tandav/ultrasonic-stethoscope/docs/tech/due.md

# some links for arduino due

If cannnot upload, arduino ide dont see port / try to change usb port / programming -> native and vice versa
- also try to upload via programming port / not native. Native sometimes stucks

---
- [DueTimer: ⏳ Timer Library fully implemented for Arduino DUE](https://github.com/ivanseidel/DueTimer)
- [SineWaveDue: Sinewave library for the Arduino Due](https://github.com/cmasenas/SineWaveDue)
- [Arduino Due: ADC → DMA → USB @ 1MSPS](https://gist.github.com/pklaus/5921022)
- [snowWhiteNoise: Spectrum Analyzer with Arduino: An Arduino Due and a PC give ...](https://github.com/hamed/snowWhiteNoise)
- [arduino-libraries/Scheduler: Scheduler Library for Arduino](https://github.com/arduino-libraries/Scheduler)
    - [Arduino - Scheduler](https://www.arduino.cc/en/Reference/Scheduler)
    - [Tasks: A Time-Triggered Scheduler for Arduino | chris barlow](https://chrisbarlow.wordpress.com/2016/04/27/tasks-a-time-triggered-scheduler-for-arduino/)
    - [Arduino Due Task Scheduler](https://forum.arduino.cc/index.php?topic=130917.0)
    - [Simple Arduino Scheduler](https://forum.arduino.cc/index.php?topic=372119.0)
    - [arduino scheduler what is yield - Google Search](https://www.google.com/search?q=arduino+scheduler+what+is+yield)
    - [Using yield () within scheduled loops](https://forum.arduino.cc/index.php?topic=450589.0)
    - [esp8266 - What is the secret of the arduino `yield()`function? - Stack Overflow](https://stackoverflow.com/questions/34497758/what-is-the-secret-of-the-arduino-yieldfunction#)
    - [Yield Function, Printable Class and Mapping Arrays : Useful But Unknown Features from Arduino Core - Atadiat](https://atadiat.com/en/e-yield-function-printable-class-mapping-arrays-useful-arduino-core/)
    - [Arduinoesp8266 Multipletasks | euphi.github.io](https://euphi.github.io/2018/03/31/ArduinoESP8266-multipleTasks.html)
    - [ESP8266 Thing Hookup Guide - learn.sparkfun.com](https://learn.sparkfun.com/tutorials/esp8266-thing-hookup-guide/using-the-arduino-addon)
