tandav/ultrasonic-stethoscope/docs/tech/bad-mic-glue.md

# Bad Mic Glue
-Новый  mic - стремно приклеен - переделать мб. Там амплитуда меньше чем у старого.
- если самому не получится то в ЧТ и пятницу (16, 17 ноября) можно с ним
- а так - разматываешь, вокруг мика клеем мажешь (либо старый плавишь) + феном прикладываешь (держишь пинцетами)
- потом усадку сверху. Она по идее стремно должна но как то
