tandav/ultrasonic-stethoscope/docs/tech/Arduino.md

Короче 2 функции `setup()` и `loop()`

В пин А(любой) вставляешь `mic`, нужно перепаять `op-amp` под `0-3.3V`

Можно протестить - подать сигнал с DAC на ADC (ну провод-перемычку наверное, хз)

В инициализации выбирать скорость com-порта. Ну там максималку поставить (250000?), по дефолту в районе 115000

И с ком порта в каком-нибудь питоне / visual студии считывать данные с ком порта, они там будут. Типа рисовать на график.

Потом короче можно изучать как не через COM, а через native-USB.
 через python / visual studio plot chart from COM-port
	- Ну и потом from native-usb

---

My app based on https://gist.github.com/pklaus/5921022

---
