tandav/ultrasonic-stethoscope/docs/master-thesis/paper/sections/0-titlepage.tex

% !TEX root = ../main.tex
\documentclass[../main.tex]{subfiles}
\begin{titlepage}

\begin{document}
\begin{spacing}{1.2}
{
\sffamily 
\begin{small}
\thispagestyle{empty}
\newgeometry{margin=2cm}
\center
\begin{singlespace}
МИНОБРНАУКИ РОССИИ\\
\begin{bfseries}
ФЕДЕРАЛЬНОЕ ГОСУДАРСТВЕННОЕ БЮДЖЕТНОЕ ОБРАЗОВАТЕЛЬНОЕ УЧРЕЖДЕНИЕ

ВЫСШЕГО ОБРАЗОВАНИЯ

``ВОРОНЕЖСКИЙ ГОСУДАРСТВЕННЫЙ УНИВЕРСИТЕТ''
\end{bfseries}
\end{singlespace}

\vspace{0.5cm}
{Факультет \textit{компьютерных наук}}\\
{Кафедра \textit{цифровых технологий}}\\

\vspace{1.5cm}

\textit{Цифровая акустическая система оценки состояния лёгких}\\

\vspace{1.5cm}

{ВКР} \textit{Магистерская диссертация}\\
\textit{02.04.01 Математика и компьютерные науки}\\
\textit{Компьютерное моделирование и искусственный интеллект}\\

\vspace{3cm}
\begin{flushleft}
{Допущено к защите в ГЭК}
\end{flushleft}
\begin{tabbing}
ооооооооооооооо	\=	----------------------	\kill
Зав. кафедрой\> 	\rule[0mm]{3cm}{0,3mm}	\textit{С.Д. Кургалин, д. ф.-м. н., профессор}{ \rule[0mm]{5mm}{0,3mm}.\rule[0mm]{5mm}{0,3mm}.2019}  \\
Обучающийся \> 	\rule[0mm]{3cm}{0,3mm}	\textit{А.А. Родионов, 2 курс, д/о} \\ 
ооооооооооооооо	\=	----------------------	\kill
Руководитель\> 	\rule[0mm]{3cm}{0,3mm}  \textit{Я.А. Туровский, к. мед. н., доцент }
\end{tabbing}

\vspace{4cm}

\centerline{Воронеж 2019}
\end{small}
}
\end{spacing}
\newpage

\end{document}
\end{titlepage}
