tandav/ultrasonic-stethoscope/docs/master-thesis/paper/sections/zadanie.tex

% !TEX root = ../main.tex
\documentclass[../main.tex]{subfiles}

\begin{document}
% \thispagestyle{empty}

{
\sffamily
\begin{small}
\begin{spacing}{1.2}
{
\begin{center}
{МИНОБРНАУКИ РОССИИ}\\ \!
{\footnotesize\textbf{ФЕДЕРАЛЬНОЕ ГОСУДАРСТВЕННОЕ БЮДЖЕТНОЕ ОБРАЗОВАТЕЛЬНОЕ УЧРЕЖДЕНИЕ}\\ \!\!\textbf{ВЫСШЕГО ОБРАЗОВАНИЯ}}\\
\textbf{<<ВОРОНЕЖСКИЙ ГОСУДАРСТВЕННЫЙ УНИВЕРСИТЕТ>>}\\
{Факультет компьютерных наук}\\
{Кафедра цифровых технологий}\\
\vspace{0.1cm}
\end{center}
\begin{flushright} \!  \!  \! \!
\textbf{УТВЕРЖДАЮ}\\
заведующий кафедрой\\
$\underset{\text{\emph{подпись}}}{\underline{\hspace{0.15\textwidth}}}$ $\underset{\text{\emph{расшифровка подписи}}}{\text{Кургалин С.Д.},}$
\end{flushright}
\begin{center}
{\small \textbf{ЗАДАНИЕ \\
НА ВЫПОЛНЕНИЕ ВЫПУСКНОЙ КВАЛИФИКАЦИОННОЙ РАБОТЫ\\
ОБУЧАЮЩЕГОСЯ} $\underset{\text{\emph{фамилия, имя, отчество}}}{\underline{\textbf{РОДИОНОВА АЛЕКСАНДРА АЛЕКСАНДРОВИЧА}}}$}
\end{center}\! \! \!
\vspace{0.1cm}
{
\footnotesize 1. Тема работы \underline{\phantom{aaa}<<Цифровая акустическая система оценки состояния лёгких>> \phantom{a}}, утверждена решением ученого совета факультета компьютерных наук от \underline{\phantom{aaa}}.\underline{\phantom{aaa}}.20\underline{\phantom{aaa}}\\
2. { Направление подготовки $\underset{\text{\emph{шифр, наименование}}}{\underline{\phantom{aaaaa}\text{02.04.01 Математика и компьютерные науки.}\phantom{aaaaa}}}$\\
3. Срок сдачи студентом законченной работы \underline{\phantom{aaa}}.\underline{\phantom{aaa}}.20\underline{\phantom{aaa}}\\
4. Календарный план:}\\
\begin{table}[h]
\centering
% \begin{tabular}{|P{3em}|p{25em}|P{12em}|P{7em}|}
\begin{tabular}{|l|l|l|l|}
\hline
{\footnotesize  №} & {\hspace{0.18\textwidth}{\footnotesize Структура ВКР}} & {\footnotesize Сроки выполнения } & {\footnotesize Примечание}\\\hline
{1} & {Введение}                                        & {03.09.2017} & {}\\\hline
{2} & {Глава 1. Цель и задачи }                         & {10.11.2017} & {}\\\hline
{3} & {Глава 2. Анализ предметной области}              & {15.02.2018} & {}\\\hline
{4} & {Глава 3. Модель распространения звука в легких}  & {06.04.2018} & {}\\\hline
{5} & {Глава 4. Аппаратная часть разработанной системы} & {20.11.2018} & {}\\\hline
{6} & {Глава 5. Програмная часть разработанной системы} & {13.02.2019} & {}\\\hline
{7} & {Заключение}                                      & {11.05.2019} & {}\\\hline
{8} & {Список использованных источников}                & {03.06.2019} & {}\\\hline
\end{tabular}
% \! \! \! \!
\end{table}

\begin{flushleft}
\vspace{0.4cm}
{\small
Обучающийся $~~~~~~~~\underset{\textit{подпись}}{\rule[-1.8mm]{3cm}{0,25mm}}$ $\underset{\textit{расшифровка подписи}}{\underline{\phantom{aaaaaaa}\text{Родионов А.А.}\phantom{aaaaaaa}}}$\\
\vspace{0.4cm}
Руководитель $~~~~~~~~~\underset{\text{\emph{подпись}}}{\rule[-1.6mm]{3cm}{0,25mm}}$ $\underset{\text{\emph{расшифровка подписи}}}{\underline{\phantom{aaaaaaaa}\text{Туровский Я.А.}\phantom{aaaaaaa.}}}$}
\end{flushleft}\! \! \! \! \! \! \! \!
}
}
\end{spacing}
\end{small}
}
\newpage

\end{document}
