tandav/ultrasonic-stethoscope/docs/bachelor-thesis/presentation.pdf

# Цифровой úирокополоснýй стетоскоп

## Вýполнил: Александр Родионов 4к 6гр

## Руководителþ: Я.А. Туровский

# Проблема

# Проблема

## - 5/10 приùин смерти в мире свзанý с заболеваними сердøа или легких (ВОЗ, 2015)

# Проблема

## - 5/10 приùин смерти в мире свзанý с заболеваними сердøа или легких (ВОЗ, 2015) - Основной инструмент медиøинской диагностики враùей первиùного звена - стетоскоп

# Проблема

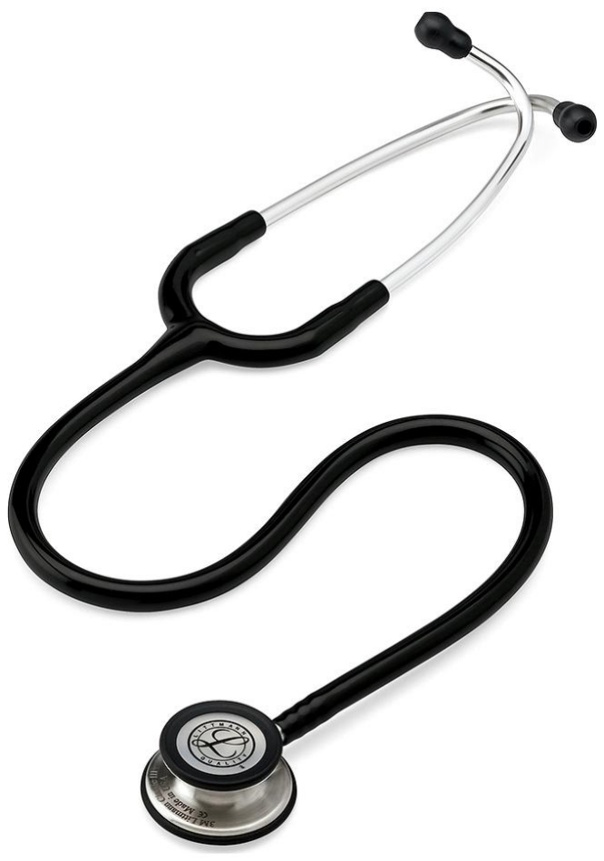
[picture p5: figure]

## - 5/10 приùин смерти в мире свзанý с заболеваними сердøа или легких (ВОЗ, 2015) - Основной инструмент медиøинской диагностики враùей первиùного звена - стетоскоп

# Проблема

## - 5/10 приùин смерти в мире свзанý с заболеваними сердøа или легких (ВОЗ, 2015) - Основной инструмент медиøинской диагностики враùей первиùного звена - стетоскоп - Информаøи, на основе которой враù назнаùает далþнейúее леùение субüективна

# Проблема

- 5/10 приùин смерти в мире свзанý с заболеваними сердøа или легких (ВОЗ, 2015) - Основной инструмент медиøинской диагностики враùей первиùного звена - стетоскоп - Информаøи, на основе которой враù назнаùает далþнейúее леùение субüективна - Естþ потребностþ в стетоскопах, которýе дат возможностþ работатþ с более обüективной информаøией

# Целþ работý

## Разработка øифрового úирокополосного стетоскопа, работаûего в

слýúимом и нижнем улþтразвуковом диапазоне (до 40кГø) и ПО к нему.

# Аналоги на рýнке

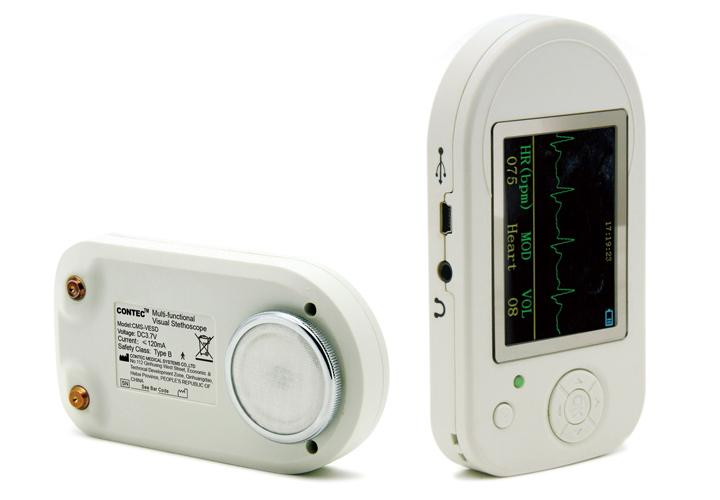
[picture p6: figure]

CMS-VESD
5800 руб

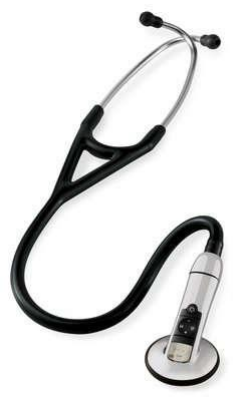
[picture p7: figure]

Littmann 3200
22000 руб

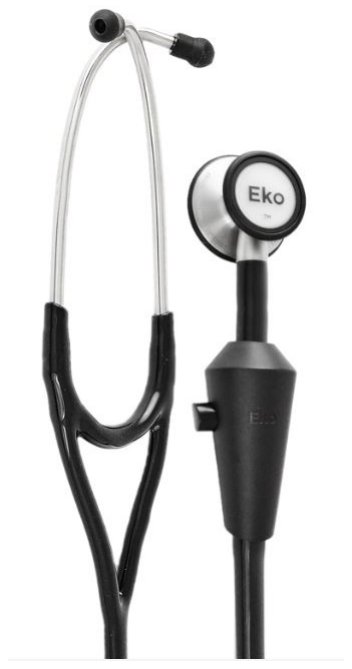
[picture p8: figure]

Eko Core
16900 руб

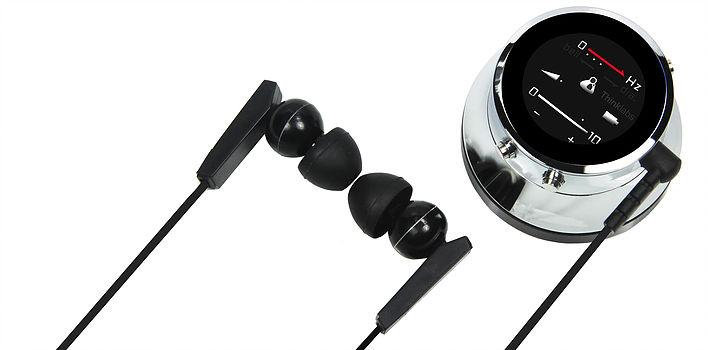
[picture p9: figure]

Thinklabs One
26800 руб

# Задаùи

# Задаùи

## 1. Вýбор микрофона

# Задаùи

## 1. Вýбор микрофона 2. Разработка усилител дл микрофона

# Задаùи

## 1. Вýбор микрофона 2. Разработка усилител дл микрофона 3. Вýбор АЦП

# Задаùи

## 1. Вýбор микрофона 2. Разработка усилител дл микрофона 3. Вýбор АЦП 4. Разработка ПО дл обработки и визуализаøии даннýх

# Задаùи

## 1. Вýбор микрофона 2. Разработка усилител дл микрофона 3. Вýбор АЦП 4. Разработка ПО дл обработки и визуализаøии даннýх 5. Разработка ПО дл вýсокопроизводителþной обработки сигнала на удаленном сервере

# Микрофон: Sven MK-200

# Микрофон: Sven MK-200

50Hz | 16kHz

Наилучшая чувствительность

# Микрофон: Sven MK-200

50Hz | 16kHz | 40kHz
Наилучшая чувствительность | С ослаблением

# Усилителþ

# Усилителþ

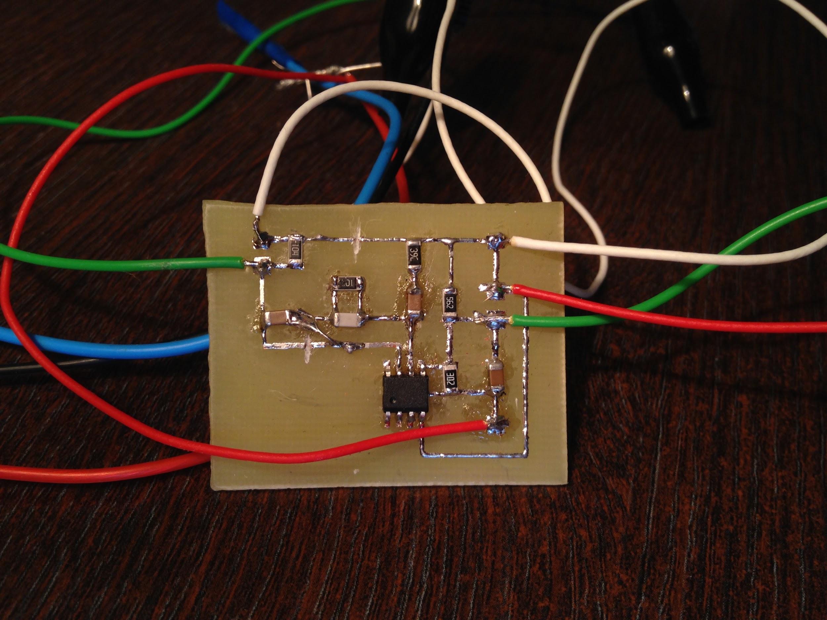
[picture p10: figure]
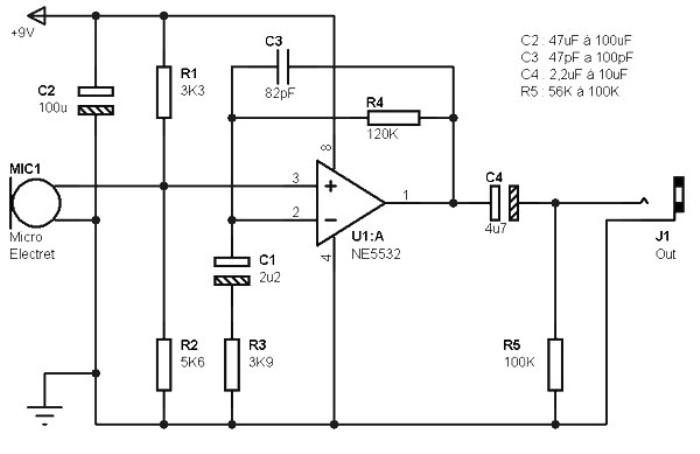
[picture p11: figure]

# Усилителþ

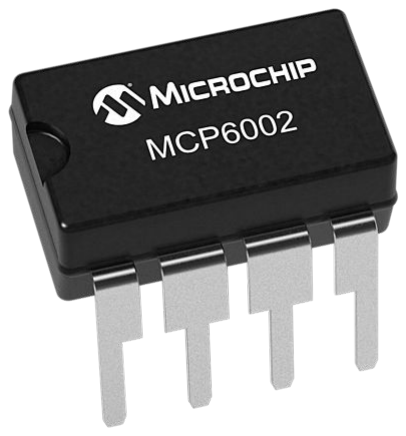
[picture p12: figure]

MSP 6022:

# Усилителþ

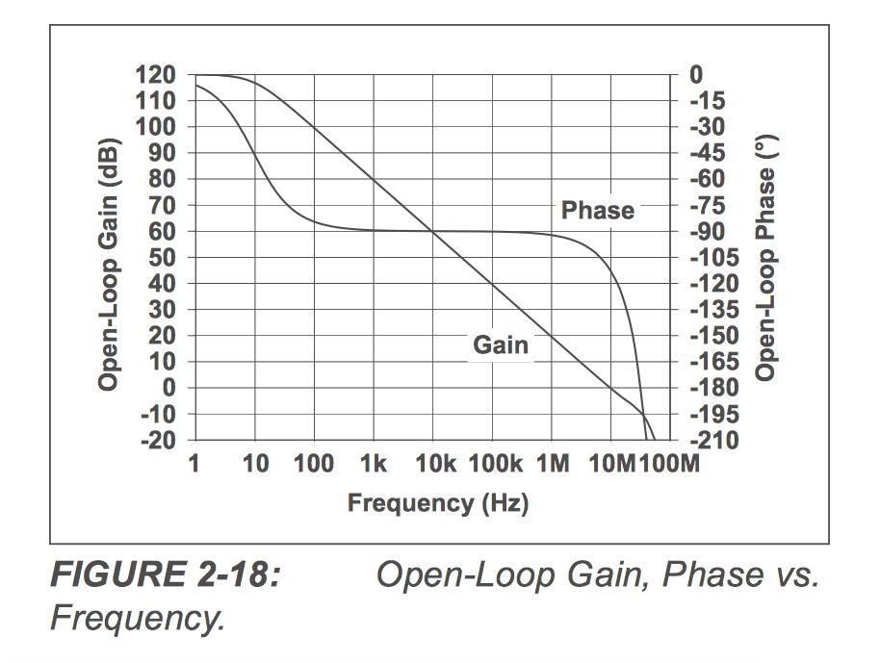
[picture p13: figure]

# Усилителþ

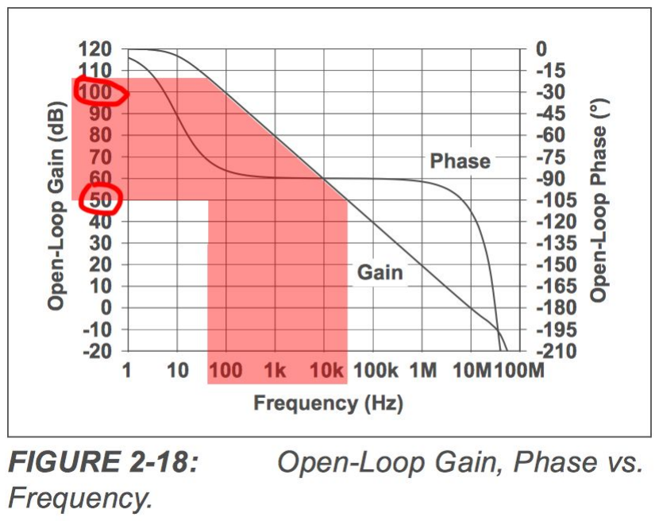
[picture p14: figure]

# АЦП

# АЦП

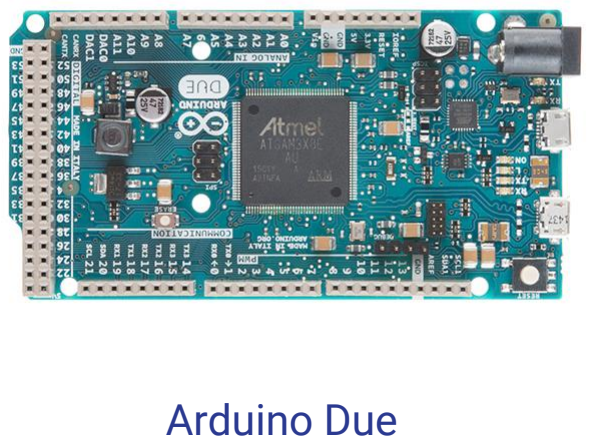
[picture p15: figure]
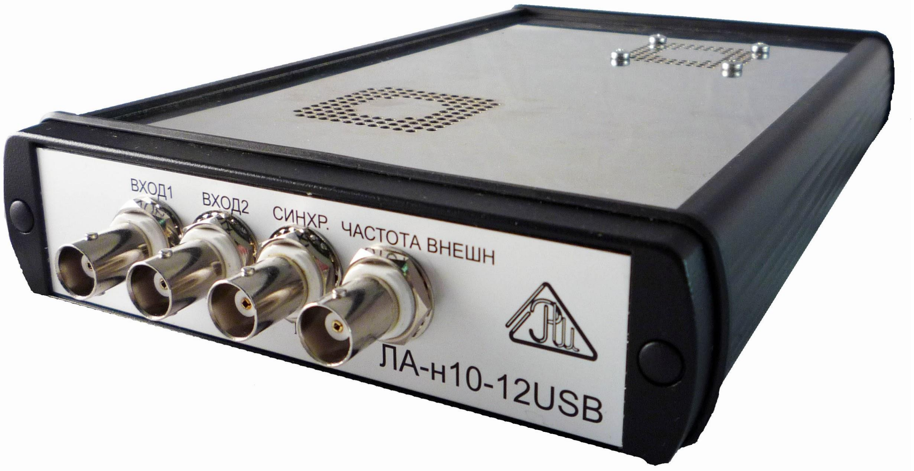
[picture p16: figure]
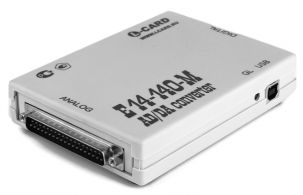
[picture p17: figure]

LCard E14-140M | ЛА-н10-12 | Arduino Due

# АЦП

LCard E14-140M | ЛА-н10-12 | Arduino Due

# АЦП

LCard E14-140M | ЛА-н10-12 | Arduino Due

# АЦП

start | read-buffer | stop

Время одного цикла

# АЦП

Размер буффера

Частота
дискр.

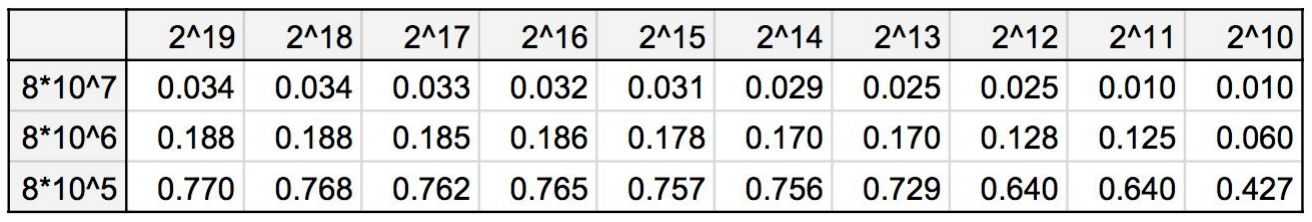
[picture p18: figure]

Отношение полезного времени к полному

# АЦП

Размер буффера

Частота
дискр.

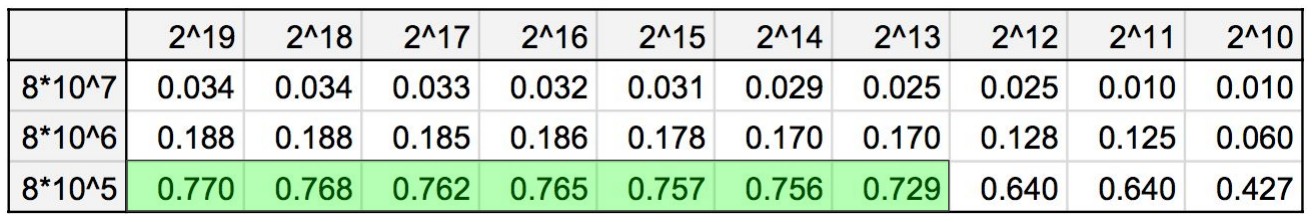
[picture p19: figure]

Отношение полезного времени к полному

# АЦП

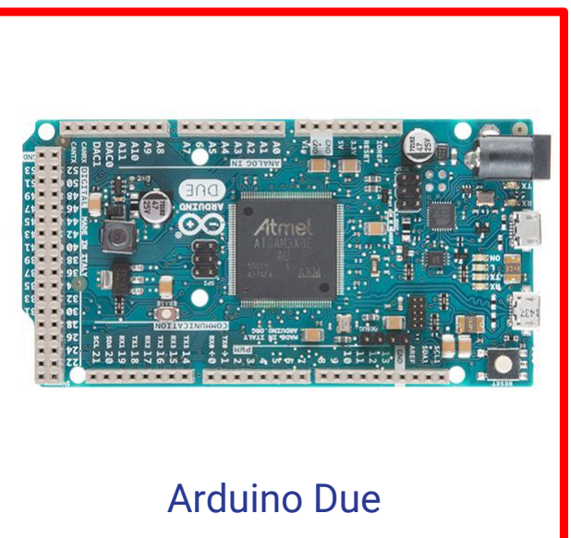
[picture p20: figure]

LCard E14-140M | ЛА-н10-12 | Arduino Due

# Стетоскоп в сборе

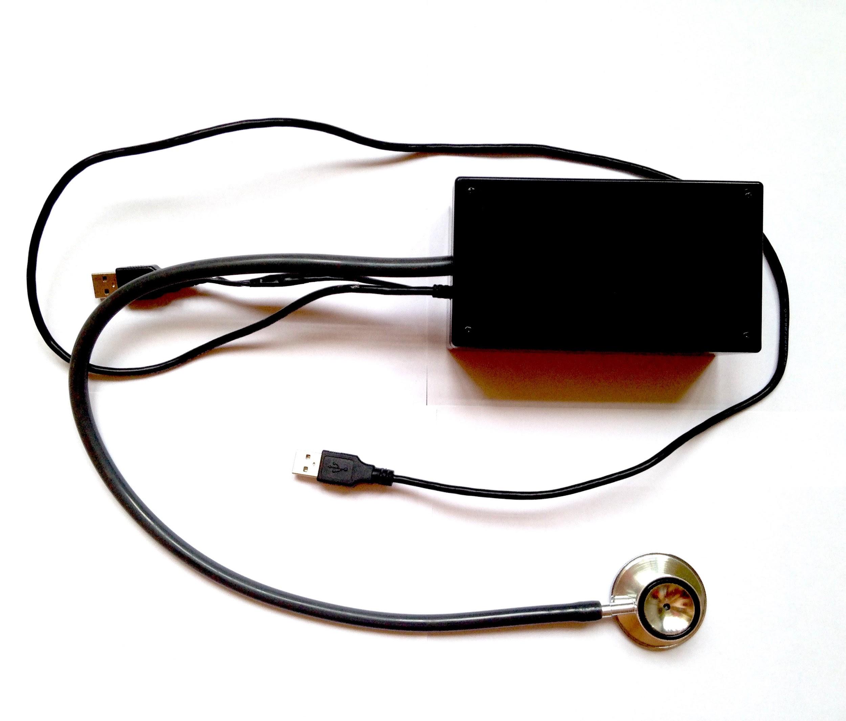
[picture p21: figure]

# Программное обеспеùение

# Программное обеспеùение

# Возможности ПО

# Программное обеспеùение

## 1. Принимает сигнал с устройства

# Возможности ПО

# Программное обеспеùение

## 1. Принимает сигнал с устройства 2. График сигнала в реалþном времени

# Возможности ПО

# Программное обеспеùение

## 1. Принимает сигнал с устройства 2. График сигнала в реалþном времени 3. Записþ сигнала на диск дл далþнейúей обработки

# Возможности ПО

# Программное обеспеùение

## 1. Принимает сигнал с устройства 2. График сигнала в реалþном времени 3. Записþ сигнала на диск дл далþнейúей обработки 4. Обработка сигнала на удаленном сервере (cloud computing)

# Возможности ПО

# Программное обеспеùение

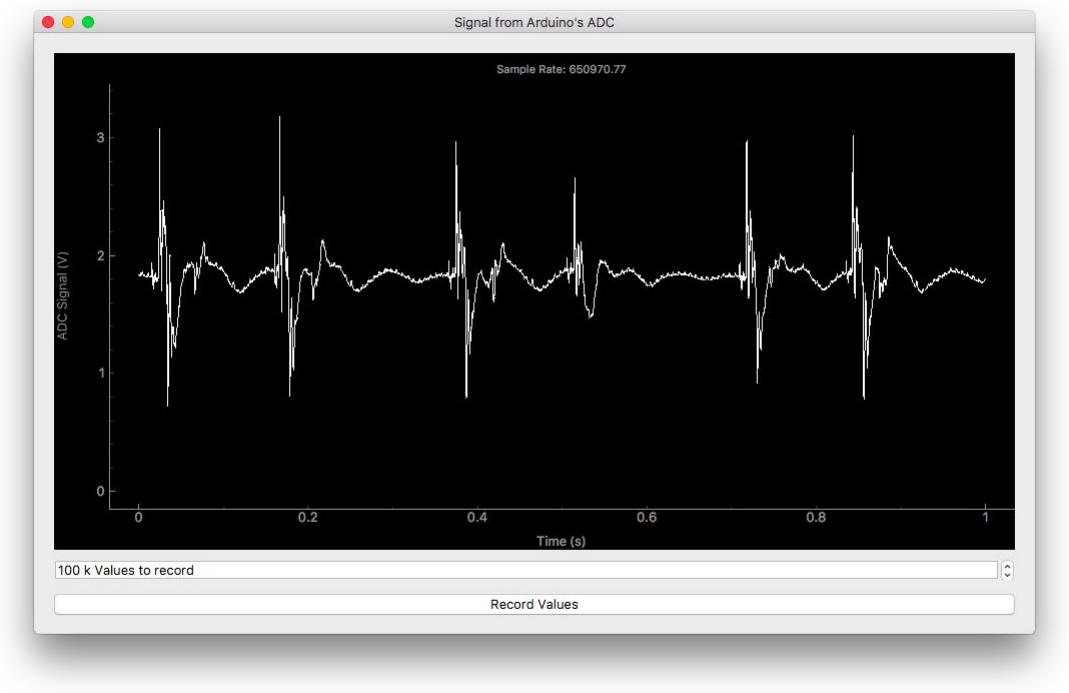
[picture p22: figure]

# Графиùеский фреймворк PyQt

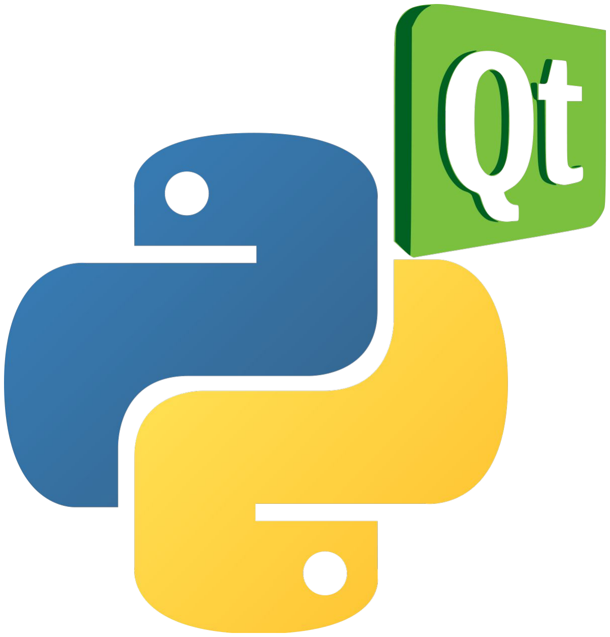
[picture p23: figure]

# Графиùеский фреймворк PyQt

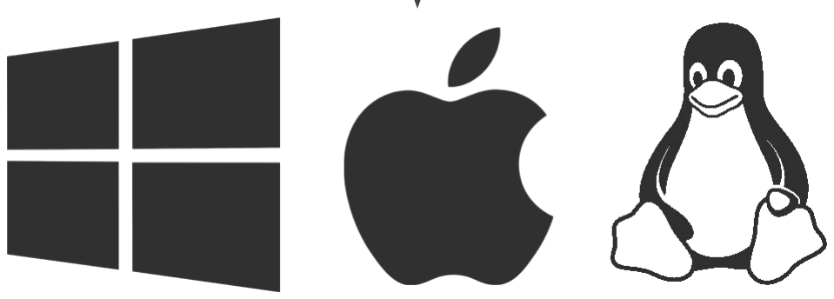
[picture p24: figure]

# Кратка схема программý

# Кратка схема программý

ADC Thread:

UI Thread:

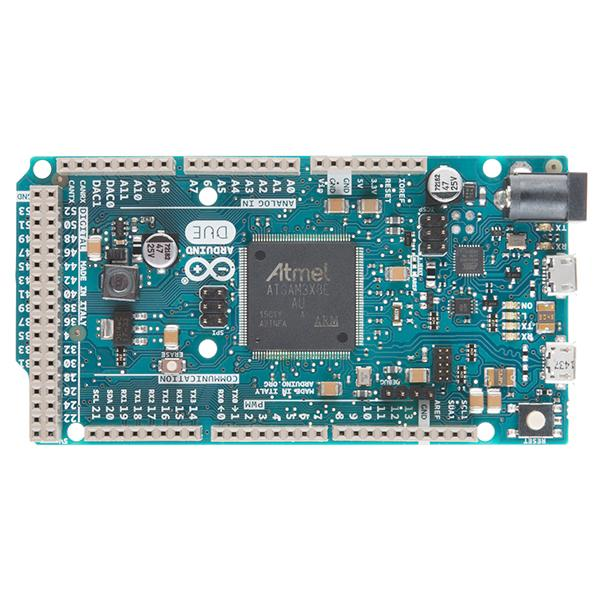
[picture p25: figure]

# Кратка схема программý

ADC Thread:

UI Thread:

# Кратка схема программý

ADC Thread:

UI Thread:

# Кратка схема программý

ADC Thread:

UI Thread:

# Кратка схема программý

ADC Thread:

UI Thread:

# Кратка схема программý

ADC Thread:

UI Thread:

# Кратка схема программý

ADC Thread:

UI Thread:

# Кратка схема программý

ADC Thread:

UI Thread:

# Кратка схема программý

ADC Thread:

UI Thread:

# Кратка схема программý

ADC Thread:

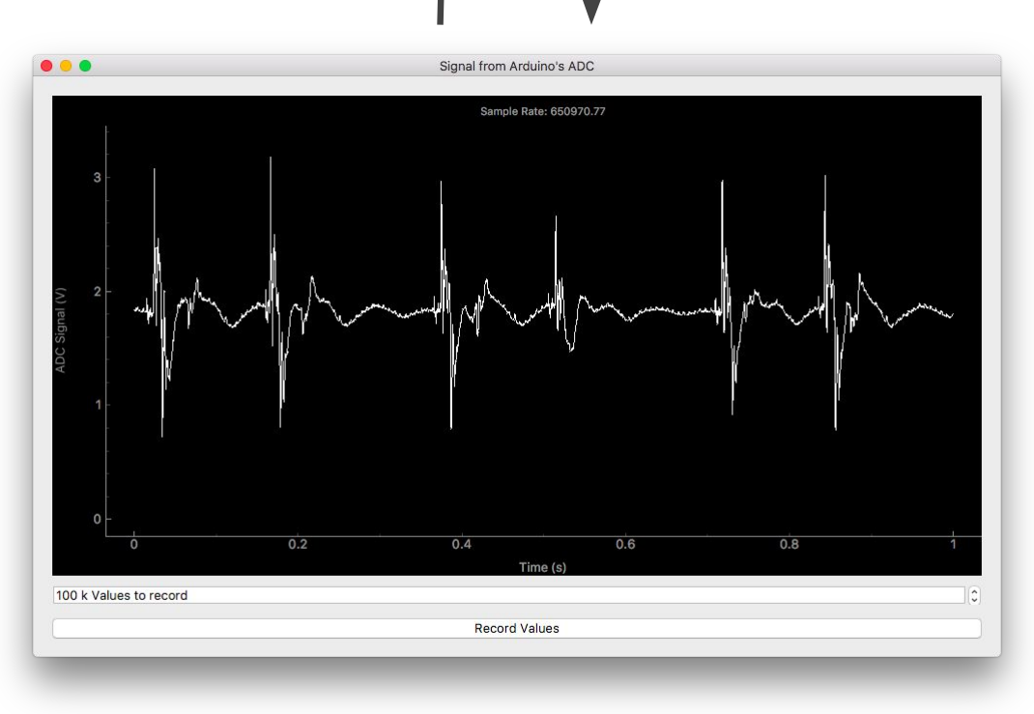
[picture p26: figure]

UI Thread:

# Кратка схема программý

ADC Thread:

UI Thread:

# Кратка схема программý

ADC Thread:

UI Thread:

# Программное обеспеùение

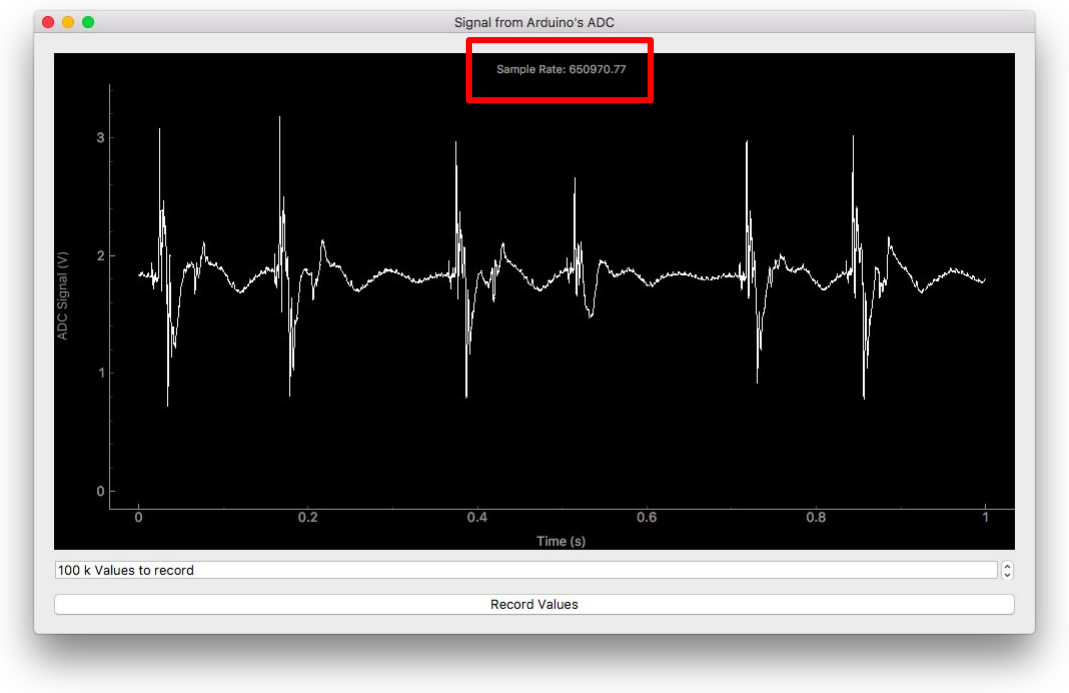
[picture p27: figure]

# Программное обеспеùение

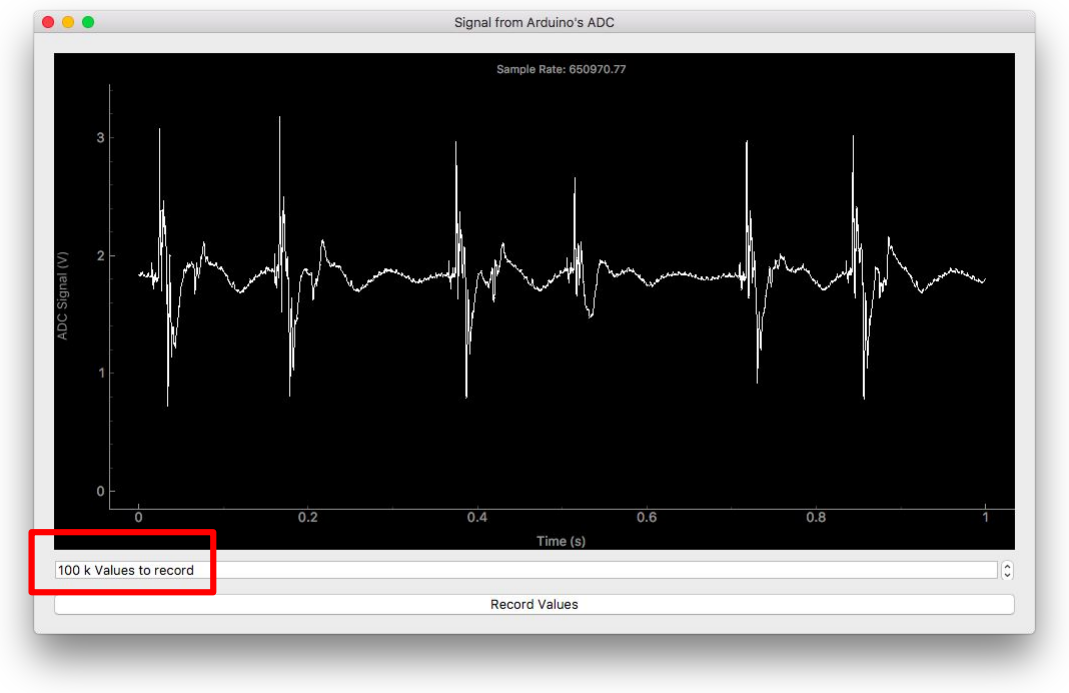
[picture p28: figure]

# Программное обеспеùение

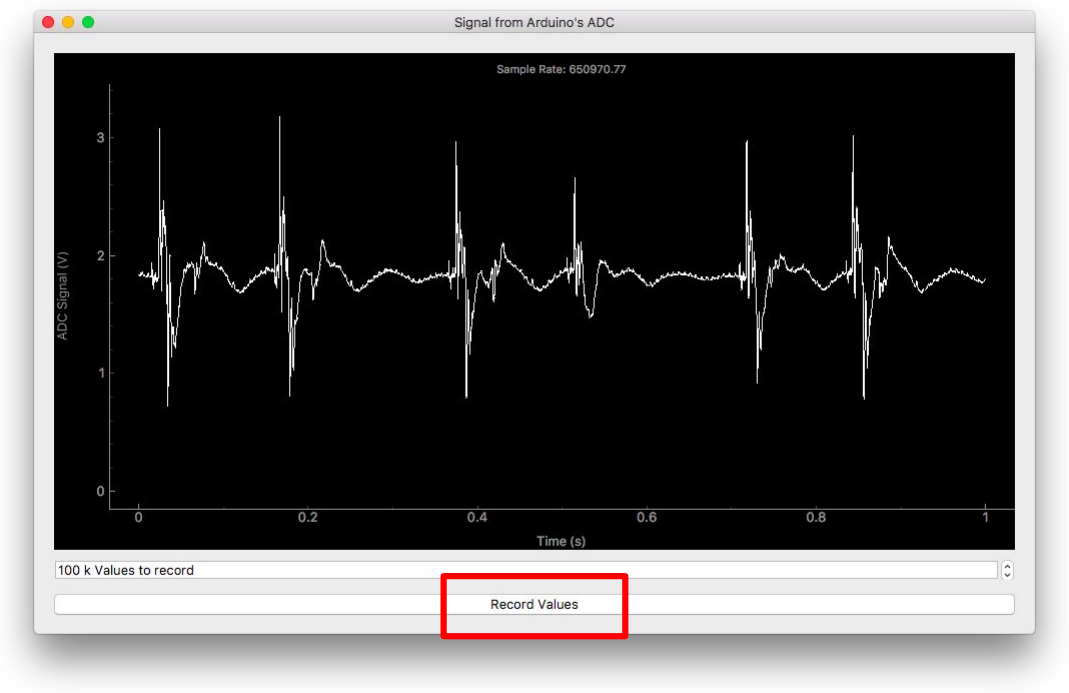
[picture p29: figure]

# Звук сердøа

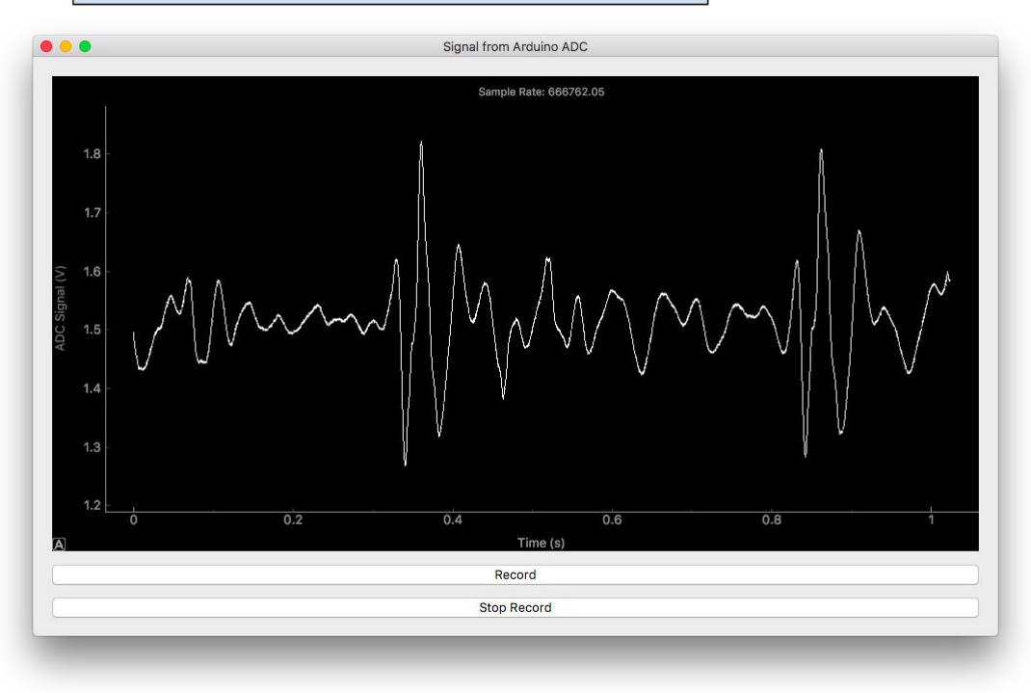
[picture p30: figure]

# Звук легких

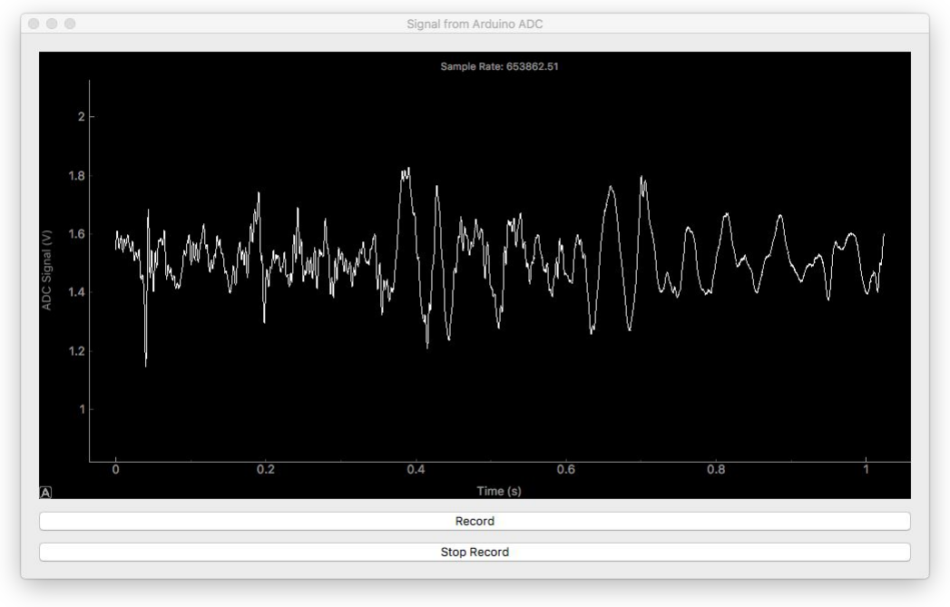
[picture p31: figure]

# FFT

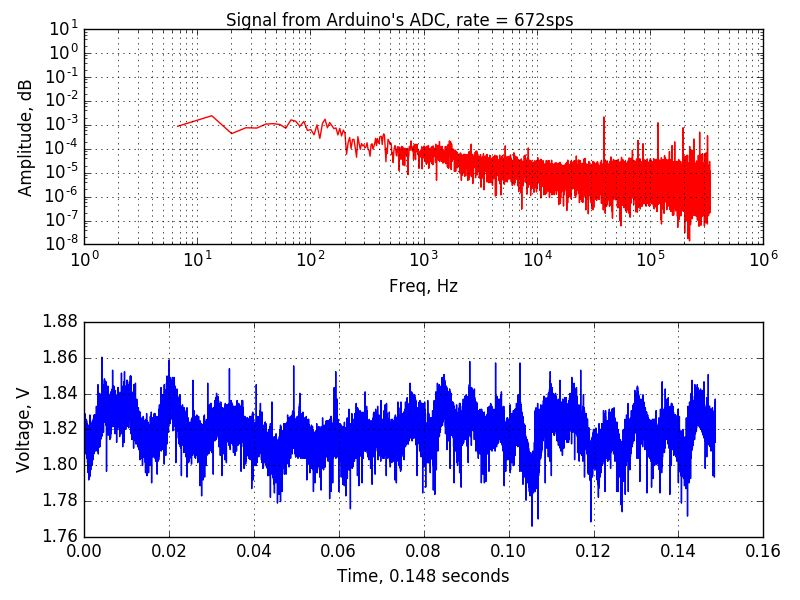
[picture p32: figure]

# FFT

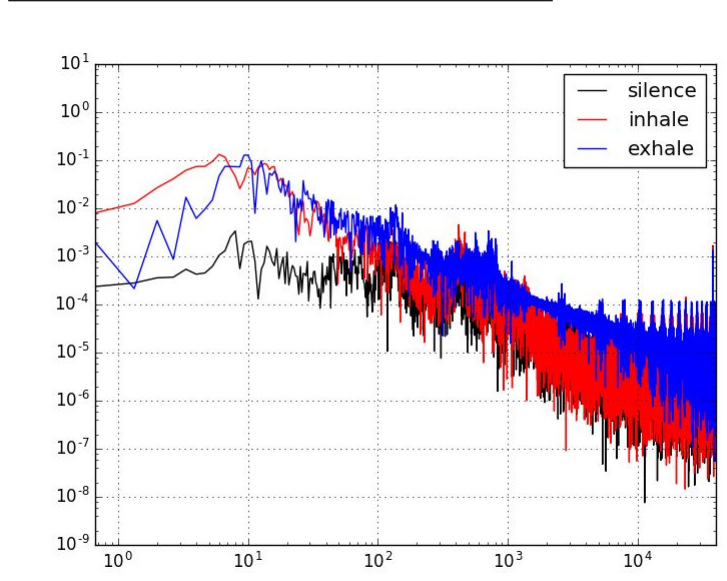
[picture p33: figure]

# CUDA Server

# CUDA Server

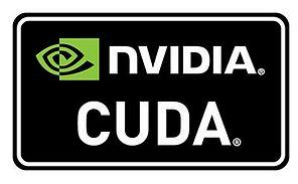
[picture p34: figure]

# CUDA Server

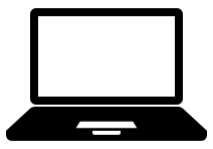
[picture p35: figure]

# CUDA Server

запись | 2.6 MBps

# CUDA Server

запись
сжатие

# CUDA Server

запись
сжатие

# gzip: 24% (от исходного)

# CUDA Server

запись
сжатие

signal.dat.gz

# CUDA Server

# FFT(signal)

запись
сжатие

signal.dat.gz

# CUDA Server

# FFT(signal)

запись
сжатие

signal.dat.gz

fft.png

# Заклùение

# Заклùение

- Создан рабоùий прототип

# Заклùение

- Создан рабоùий прототип
- Прием сигнала вýсокого каùества

# 40kHz

# Заклùение

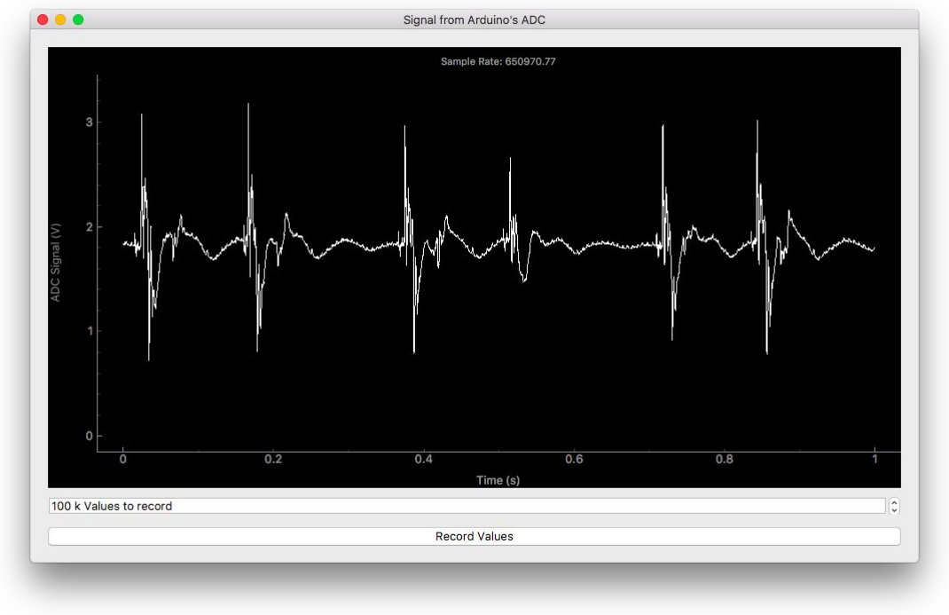
[picture p36: figure]

- Создан рабоùий прототип
- Прием сигнала вýсокого каùества
- Визуализаøи сигнала в реалþном времени

# Заклùение

- Создан рабоùий прототип
- Прием сигнала вýсокого каùества
- Визуализаøи сигнала в реалþном времени
- Вýùисление FFT

# Заклùение

- Создан рабоùий прототип
- Прием сигнала вýсокого каùества
- Визуализаøи сигнала в реалþном времени
- Вýùисление FFT
- Вýсокопроизводителþнýе вýùислени на удаленном сервере

# Заклùение

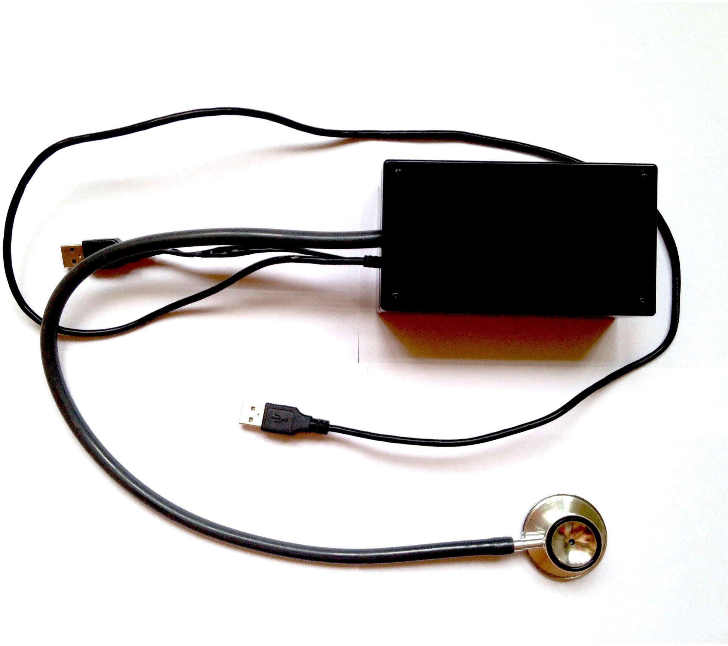
[picture p37: figure]

- Создан рабоùий прототип
- Прием сигнала вýсокого каùества
- Визуализаøи сигнала в реалþном времени
- Вýùисление FFT
- Вýсокопроизводителþнýе вýùислени на удаленном сервере
- Сфера применени не ограниùена медиøиной

# Спасибо за внимание

1. Аналого øифровой преобразователþ ЛА-н10-12 http://www.rudshel.ru/show.php?dev=14
2. Драйверý и програмное обеспеùение дл устройств ЗАО "Руднев-Шилев" http://rudshel.ru/software.html
3. Документаøи по программировани устройств ЗАО "Руднев-Шилев" http://www.rudshel.ru/soft/SDK2/Doc/CPP_USER_RU/html/index.html
4. Руководство полþзовател ЛА-н10-12USB http://www.rudshel.ru/pdf/LA-n10-12USB(y).rar
5. Аналого øифровой преобразователþ E14-140-M http://www.lcard.ru/products/external/e-140m
6. Руководство полþзовател и техниùеские характеристики операøионного усилител MCP6022 https://lib.chipdip.ru/291/DOC000291231.pdf
7. Исходнýй код, документаøи и ÿтапý создани проекта улþтразвукового стетоскопа https://github.com/tandav/ultrasonic-stethoscope

# Ссýлки

# Спасибо за внимание

1. Аналого øифровой преобразователþ ЛА-н10-12 http://www.rudshel.ru/show.php?dev=14
2. Драйверý и програмное обеспеùение дл устройств ЗАО "Руднев-Шилев" http://rudshel.ru/software.html
3. Документаøи по программировани устройств ЗАО "Руднев-Шилев" http://www.rudshel.ru/soft/SDK2/Doc/CPP_USER_RU/html/index.html
4. Руководство полþзовател ЛА-н10-12USB http://www.rudshel.ru/pdf/LA-n10-12USB(y).rar
5. Аналого øифровой преобразователþ E14-140-M http://www.lcard.ru/products/external/e-140m
6. Руководство полþзовател и техниùеские характеристики операøионного усилител MCP6022 https://lib.chipdip.ru/291/DOC000291231.pdf
7. Исходнýй код, документаøи и ÿтапý создани проекта улþтразвукового стетоскопа https://github.com/tandav/ultrasonic-stethoscope

# Ссýлки

# Спасибо за внимание

# Заклùение

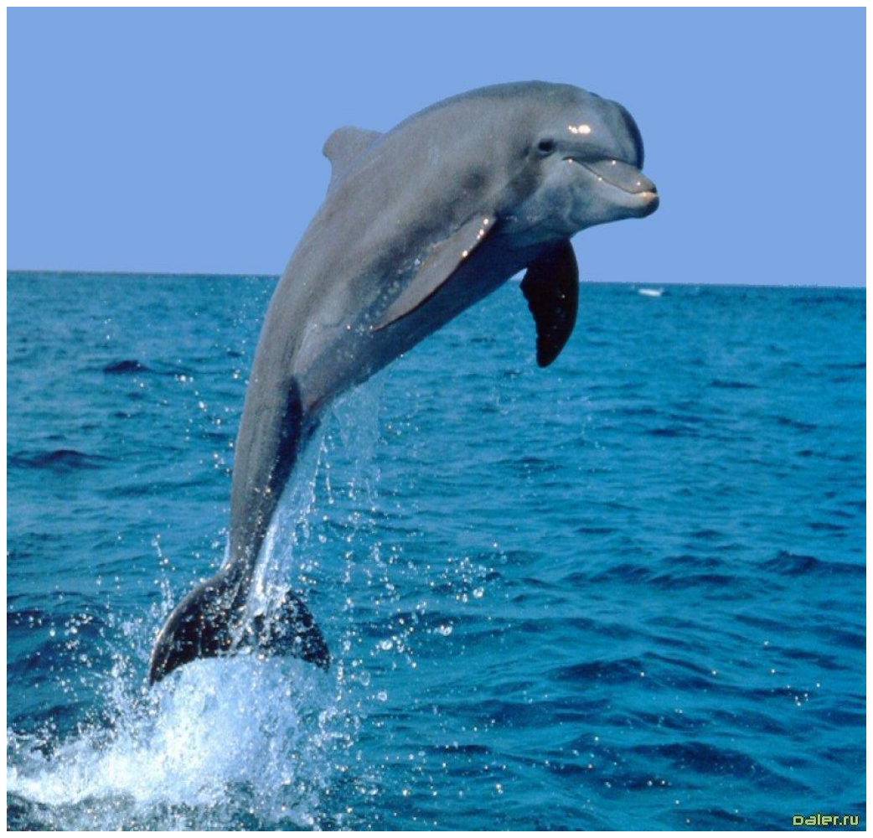
[picture p38: figure]

- Создан рабоùий прототип
- Анализ сигнала в реалþном времени
- Вýùислени на удаленном сервере
- Сфера применени не ограниùена медиøиной

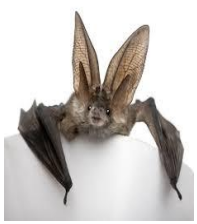
[picture p39: figure]
