tandav/ultrasonic-stethoscope/docs/lungs-model-predz/predz-2018.5.31.md

# предзащита 31 May 2018
Must have:
Название работы (точное)
Вып.: Студент, научрук (данные)
Цель работы
Задачи работы (все, минимум 4-5 задач)
Список литературы
//Сама работа: создание ПО, системы, тестирование...
Обсуждение результатов

Обязательно обосновать актуальность и новизну работы

Обязательна публикация в научном сборнике, если хочешь хорошую оценку

Презентацию сдаём на оценку

----------------------------------------------------------------

Alexander Rodionov, [24 May 2018 at 5:11:12 PM]:
- нужна презентация в след раз
- нужно название работы
- цель работы
- задачи, котоорые должны били решены или уже решены (4-5 задач), одна из них - изучение списка литературы / инфы в инете
- актуальность работы / почему она нужна / новизна 
- публикации / без публикаций только тройка будет на защите
- ну и дальше суть / модель / алгоритм / графики / схемы / порядок действий

----------------------------------------------------------------

# Название: Компьютерная модель распространения звука в легких
- вып: Родионов АА(студент 1к маг), научрук Туровский ЯА (к.мед.н, доцент)

# Цель работы
 ρ
