tandav/ultrasonic-stethoscope/docs/umnik/cover-letter.md

Проект Родионова А. А. направлен на решение актуальной проблемы, стоящей перед врачами первичного звена и узкими специалистами в области педиатрии, физиотрии, пульманологии.

Проект направлен на объективизацию и автоматизацию получения данных при аускультативном обследовании. 

Особый интерес предоставляет возможность расширения получения данных на низкочастотный ультразвуковой диапазон. Особо отметим уже существующий задел в виде программно-аппаратных решений, обеспечивающих автоматизированную регистрацию аускультативных данных в широком диапазоне частот с их последующей обработкой. В случае достижения проектом заявленных результатов программно аппар решение беусловно будет предоставл интерес для вврачей первичного звена и узких спецалистов, а также для проведения научных исследований.

bogdanshum@gmail.com

Письмо от Туровского
