tandav/ultrasonic-stethoscope/docs/umnik/umnik-speaker-notes.md

# Umnik Speaker Notes - РАСПЕЧАТАТЬ
## Вступление
`актуальность` `какую проблему решает` `цель работы` `30sec`
- 5/10 причин смерти в мире связаны с заболеваниями сердца или легких (ВОЗ, 2015)
    - add: В связи с этим большое значение имеет диагностика этих заболеваний.
- Один из основных инструментов медицинской диагностики врачей первичного звена - **стетоскоп**
    - (Ну, стетоскоп - это медицинский прибор для выслушивания звука, исходящихего от сердца, лёгких, сосудов и других органов)
- Информация, на основе которой врач назначает дальнейшее лечение **субъективна**
    - Субъективность обеспечивается опытом, качеством слуха и параметрами стетоскопа врача.
- Есть потребность в стетоскопах, которые дают возможность работать с **более объективной информацией**
- Данный проект поможет врачам работать с более **объективными численными данными** нежели простое прослушивание стетоскопом. данный проект решает проблему субъективности

## Научно-техническая новизна
У меня две новизны:
### 1. больший диапазон
(по ср с аналогами) - лучше ацп, фильтры и усилитель.
- Существующие на рынке электронные стетоскопы обладают низкой разрешающей способностью. Все которые нашлись были до 2000Гц. Соответственно в них теряется масса информации. Ну кроме первого, но он ваще низкого качества - записывает звук всего лишь до 800Гц
- существенно расширится информация, получаемая для анализа состояния пациента. 
- Также они достаточно дорогие видим аналоги достаточтно дорогоие.(диапазон от 5 до 25 тыс, но за 5 тысяч хреновое качество по сравн с нам)\
Ардуинка btw стоит $40 - примерно 2.5 тыщи **Примерно 5 тысяч себестоимость сказать, но при серийном производстве цена снизится**
- И у них нет плюшек по классификацции.
- где визуализация - сказать типа чтобы прям для стетоскопов - там не особо с визуализацией. Они обычно просто запись делают.

### помощь врачу в принятии решения (сказать что у аналагов такого нет) `чисто на словах`
- типа у нас специальное ПО на основе машинного обучения - бла бла бла
Классификация полученных данных для помощи врачу на основе алгоритмов машинного обучения.
    - Не окончательный (там анализы, жесткая диагностика), а помощь на первом этапе

Сказать что такое классификация. типа на вход сигнал, на выходе - какая болезни.

аналоги - типа чисто для прослушки, у них нету програмного анализа заболевания

- сказать про обработку на удаленном сервере
    - Мб типа как Хван сказал - устройство просто запись делает и отправляет на сервак. А он все там считает и прилетает диагноз??

- где Specgram
    - На графике изображен вдох
    - Такая визуализация помогает анализировать различн характеристики сигнала, выявлять особенности различных заболеваний

- обрабатываться вся эта классификация будет на сервере

## Commercial appeal
`кому это будет интересно` `покупатели` `клиенты` `предприятие` 

### Рыночная ниша `DONE`
Наши потенциальные клиенты: 
- гос. поликлиники
- частные клиники
- больницы
- медвузы (исследования в университетах, мед вузах, лабораториях)
- самостоятельное использование пациентами в рамках телемедецины

Первоначально мы планируем занять 5-10% этого рынка.

---

DEL
- Мы считаем сколько в россии поликлиник / участковых - если кажый 10 участковый купит то будет примерно 6000 покупателей
- примерно 15 устройств в медвузы 
- частные клиники - взять количество частных клиник. и взять 10%. 

---

### Показатели `DONE`
- себестоимость - 5000р
- EBITDA - доналоговая прибыль. Earnings before interest, taxes, deprecation, amortisation.
    - при больших партиях (допустим 6000 устройств себестоимость будет примерно 2500) Но продавать будем по 5000. 
    - поэтому прибыль будет `5000 * 6000 = 30 000 000 - 2500 * 6000 = 15 000 000`
    - доллар не дороже 70р, а евро не дороже 80
- ARPU (Average Revenue per User) - средняя выручка в месяц на 1 абонента. У нас будет использоваться сервис вычисления на серваке - ARPU планируем 500р / мес на чувака

### Поквартально
1. - совершенствование по для обработки сигналов
2. разработка серверного ПО
3. тестирование ПО, исправление багов
4. получение обратной связи от врачей, оптимизация интерфейсов
5. разработка многоканального устройства (много миков).
6. Сбор данных для формирования медицинских нормативов.
    - Записываем много здоровых людей и смотрим какие записи в норме. Создание базы нормальных.
7. база данных по больным / по отклонениям
8. Итоговое тестирование и исправление 

про письмо просто сказать что оно есть (будет от больницы - сделает)

- про 500 тыс ниче не говорить

### маркетинг
- прямые контакты
- участие в выставках
- предоставление на пробный период
- работа с организаторами здравоохранения

### что выигрывает покупатель
- пациент получает возможность дистанционной телемедицинской оценки своего состояния. Не надо идти в больницу.

### что выигрывает предприятие
- улучшение диагностики, снижение числа врачебных ошибок, штрафов. Больше пациентов - больше выручка. Хороший прибор - пойдут люди.
