tandav/ultrasonic-stethoscope/docs/tech/Home.md

# Some help notes
## General Tips
- `Form1()` - called when Form1 Created
- `Form1_Load()` - called when Loaded (don't use this?)
- Use `array.Average()` method.

- [Real Time Audio Stuff (FFT/LPC Envelope from Audio Device) — Will Forfang](http://www.willforfang.com/misc-python/2015/12/9/real-time-audio-visualizationprocessing)
- https://github.com/mherrmann/pyqt-resources/wiki
- https://stackoverflow.com/questions/4938723/what-is-the-correct-way-to-make-my-pyqt-application-quit-when-killed-from-the-co

## authors
- Родионов Александр Александрович
- Туровский Ярослав Александрович
- Богатиков Евгений Васильевич
