tandav/ultrasonic-stethoscope/docs/tech/CUDA-Server.md

I use Vakhtin's library (dll) to work with CUDA. There is a method that calculates FFT:

```cs
CUDA.CUFT.Furie(block, fft, block_size)
``` 

Короче она выбрасывает ошибку при некоторых (9 штук) размерах массива. Как на картинке. И поэтому я юзаю массивы кратные 1000 (actually, powers of 10), а не степени двойки.



Вот прога, с помощью которой я нашел эти проблемные размеры:
