tandav/ultrasonic-stethoscope/docs/bachelor-thesis/whitepaper/paper.tex

%!TEX TS-program = xelatex
%!TEX encoding = UTF-8 Unicode
\documentclass[a4paper, 14pt]{extarticle}
\usepackage[left=3cm, right=1.5cm, top=2cm, bottom=2cm]{geometry}
\geometry{a4paper}                   % ... or a4paper or a5paper or ...
\usepackage{fontspec,xltxtra,xunicode}
\usepackage{listings} 
\lstset{
    breaklines=true,
    basicstyle=\small\ttfamily,
	inputencoding=utf8
}

% \setlength{\cftbeforesectionskip}{1.1pt}

\defaultfontfeatures{Mapping=tex-text}
\setmainfont{Times New Roman}
\newfontfamily{\cyrillicfontsf}{Arial}
\setsansfont{Helvetica}
\newfontfamily{\cyrillicfonttt}{Menlo}
\setmonofont{Menlo}
\usepackage{newtxmath}

\usepackage{caption}
\captionsetup[figure]{name=Рисунок, labelsep=endash}
\captionsetup[table]{labelsep=endash}

\usepackage{tocloft}
\cftsetindents{section}{0em}{2em}
\cftsetindents{subsection}{0em}{2em}
\setlength{\cftbeforesecskip}{0pt}
% \setlength{\cftbeforetoctitleskip}{-3pt}
% \setlength{\cftaftertoctitleskip}{0pt}

\renewcommand\labelitemi{---}

\usepackage{polyglossia}
\setmainlanguage{russian}
\setotherlanguage{english}
\setkeys{russian}{babelshorthands=true}

\makeatletter 
\renewcommand\@biblabel[1]{#1} 
\makeatother

\usepackage{float}
\usepackage{amsmath}
\usepackage{graphicx}
\usepackage{subcaption}
\usepackage{subfiles}
\usepackage[colorinlistoftodos]{todonotes}
\renewcommand{\baselinestretch}{1.5}
\PassOptionsToPackage{hyphens}{url}\usepackage{hyperref}
\hypersetup{
    colorlinks,
    citecolor=black,
    filecolor=black,
    linkcolor=black,
    urlcolor=black
}
\usepackage{relsize}
\renewcommand*{\UrlFont}{\ttfamily\smaller\relax}

\usepackage{setspace}
\newcommand{\sectionbreak}{\clearpage}
\usepackage{titlesec}
\titleformat{\section}[block]{\normalsize\bfseries\centering}{\thesection}{1ex}{}
\titleformat{\subsection}[block]{\normalsize\bfseries}{\thesubsection}{1ex}{}
\titleformat{\subsubsection}[block]{\normalsize\bfseries}{\thesubsubsection}{1ex}{}
\usepackage{indentfirst}

\addtocontents{toc}{\protect\vskip12pt}

% \usepackage{etoolbox}
% \patchcmd{\tableofcontents}{\@starttoc}{\vspace{-2cm}\@starttoc}{}{}

\begin{document}

\begin{titlepage}
\subfile{sections/0-titlepage}
\end{titlepage}

\subfile{sections/1-abstract}
\newpage  

\tableofcontents
\newpage 

\section*{Введение}
\addcontentsline{toc}{section}{\protect\numberline{}Введение}%
\subfile{sections/2-introduction}
\newpage  

\section{Цели и задачи}
\subfile{sections/3-motivation}
\newpage

\section{Анализ предметной области}
\subfile{sections/4-market}
\newpage

\section{Описание аппаратной части разработанной системы широкополосного стетоскопа}
\subfile{sections/5-hardware}
% \newpage

\section{Описание программного обеспечения}
\subfile{sections/6-software}
\newpage

\section*{Выводы}
\addcontentsline{toc}{section}{\protect\numberline{}Выводы}%
\subfile{sections/7-conclusion}
\newpage

\section*{Заключение}
\addcontentsline{toc}{section}{\protect\numberline{}Заключение}%
\subfile{sections/7-conclusion2}
\newpage

\addcontentsline{toc}{section}{\protect\numberline{}Список использованных источников}%
\subfile{sections/8-bibliography}

\end{document}
