tandav/ultrasonic-stethoscope/docs/master-thesis/paper/sections/7-conclusion2.tex

% !TEX root = ../main.tex
\documentclass[../main.tex]{subfiles}
\begin{document}
\section*{Заключение}
\addcontentsline{toc}{section}{\protect\numberline{}Заключение}%

В результате данной работы был создан рабочий прототип устройства, позволяющего анализировать в реальном времени звуковой сигнал высокого качества Также было написано програмное обеспечение к этому прибору. Програмное обеспечение позволяет позволяет записывать и анализировать звуковые сигналы в реальном времени. Есть возможность рассмотреть различные характеристики сигнала, такие как спектр Фурье, скользящее среднее. Также есть возможность записывать аудиосигнал на жесткий диск для его последующей обработки. Сигнал записывается с частотой дискретизации 660кГц. Данная частота позволяет анализировать ультразвуковой сигнал до 330кГц.

Данное устройство предназначено для получения дополнительной информации из звука поступающего от сердца, легких и других внутренних органов, которую нельзя услышать на обычном стетоскопе. Данная дополнительная информация может быть использована врачом для осуществления более качественной медицинской диагностики.

Развитие проекта можно продолжить в направлении улучшения качества звука. Для этого нужно использовать более качественный микрофон, который будудет обладать более высокой границей воспринемаемых частот и более качественный усилитель. Также нужно произвести опрос врачей о том, какие именно характеристики звука со стетоскопа важны.

Улучшений в програмном обеспечении можно достигнуть путем оптимизации алгоритмов распаралеливания на нескольких ядрах процессора или на видеокарте. Также, на основе информации от докторов, можно сделать систему распознавания различных забовалеваний легких и сердца.

Разработка данного проекта велась с помощью системы контроля версий git. Исходный код програмного обеспечения, этапы создания и документация доступны по адресу: \cite{github}
\newpage

\end{document}
