tandav/ultrasonic-stethoscope/stetoskop/tsifrovoi-stietoskop.pdf

минобрнауки россии

федеральное государственное бюджетное образовательное учреждение

высшего профессионального образования
Воронежский государственный университет

Факультет компьютерных наук

010200 Математика и компьютерные науки

курсовая работа

# Цифровой стетоскоп

Зав. кафедрой: С.Д. Кургалин, д. ф-м н., проф. Студент: А.А. Родионов, 3 курс, гр 6.1 Руководитель: Я.А. Туровский, к. мед. н , доцент

Воронеж 2016

## Содержание

1 Введение | 3
2 Цель работы | 4
3 Описание устройства | 5
4 Описание компьютерной программы | 7
5 Заключение | 8
6 Список литературы | 9

## 1 Введение

Сердечно-сосудистые заболевания - самая распространенная причина смерти в мире по данным Всемирной Организации Здравоохранения (ВОЗ). Также распространенными являются заболевания легких. Своевременное наблюдение за состоянием сердца и легких, и обнаружение заболеваний - важная задача здравоохранения.

3

## 2 Цель работы

Целью данной курсовой работы является создание доступного и простого в производстве цифрового стетоскопа способного организовать прослушивание легких и сердца человека. Данный цифровой стетоскоп работает в паре с компьютерной программой. Программа позволяет просматривать аудиосигнал в визуальном виде. Также можно увидеть спектр данного сигнала, полученный с помощью преобразования Фурье аудиосигнала со стетоскопа.
Это устройство поможет лучше анализировать звук сердца. С помошью визуализации сигнала можно получить больше информации о звуке внутренних органов, чем простое прослушивание.

4

## 3 Описание устройства

Устройство состоит из нескольких частей соединенных между собой. От аналогового стетоскопа берется мембрана и соединительная трубка. С одной стороны к соединительной трубке подсоединяется мембрана, с другой - микрофон. Сигнал с микрофона подается на усилитель. С усилителя сигнал подается на Аналогово-Цифровой-Преобразователь (АЦП). Аналогово-Цифровой-Преобразователь подключается к компьютеру через USB-порт.

Краткая схема прибора:

Мембрана → Соединительная Трубка → Микрофон → Усилитель → АЦП → Компьютер

3.1 Выбранный микрофон

В качестве микрофона был выбран SWEN MK-200.

Таблица 1: Технические характеристики SWEN MK-200
Чувствительность, дБ | -60 ± 3
Диапазон частот, Гц | 50 – 16 000
Размер микрофонного модуля, мм | 9×7
Тип разъема | мини-джек Ø 3,5 мм (3 pin)
Длина кабеля, м | 1,8
Вес, г | 63

3.2 Выбранный Усилитель

Lorem Ipsum is simply dummy text of the printing and typesetting industry. Lorem Ipsum has been the industry’s standard dummy text ever since the 1500s, when an unknown printer took a galley of type and scrambled it to make a type specimen book. It has survived not only five centuries, but also the leap into electronic typesetting, remaining essentially unchanged. It was popularised in the 1960s with the release of Letraset sheets containing Lorem Ipsum passages, and more recently with desktop publishing software like Aldus PageMaker including versions of Lorem Ipsum.

3.3 Выбранный АЦП

Lorem Ipsum is simply dummy text of the printing and typesetting industry. Lorem Ipsum has been the industry’s standard dummy text ever since the 1500s, when an unknown printer took a galley of type and scrambled it to make a type specimen book. It has survived not only five centuries, but also the leap into electronic typesetting, remaining essentially unchanged. It was popularised in the 1960s with the release of

5

Letraset sheets containing Lorem Ipsum passages, and more recently with desktop publishing software like Aldus PageMaker including versions of Lorem Ipsum.

6

## 4 Описание компьютерной программы

4.1 О программе

Компьютерная программа для обработки сигнала со стетоскопа написана на языке python c использованием библиотеки pyaudio (для работы со звуком) и библиотеки matplotlib (для визуализации сигналов с помощью графиков)

4.2 GUI Parameters

В данном участке кода можно выбрать параметры отображения Графического Интерфейса Пользователя (Graphical User Interface / GUI) Представлено три параметра:

timeDomain
freqDomain
lpcOverlay

Каждый из параметров может принимать значение True или False. В соответсвии с этими параметрами на экране будут(True) или не будут(False) отображаться соответсвующие элементы.
Параметр timeDomain отвечает за отображение звуковой волны. (Зависимость амплитуды сигнала от времени).
Параметр freqDomain отвечает за отображение спектра Фурье звукового сигнала. (Зависимость амплитуды сигнала от частоты).
Параметр lpcOverlay отвечает за отображение усредненного спектра Фурье звукового сигнала. (Апроксимация спектра Фурье многочленами)

4.3 Stream Parameters

В данной секции можно настроить параметры захвата аудио с микрофона. Представлено шесть параметров настройки:

DEVICE
CHUNK
WINDOW
FORMAT
CHANNELS
RATE

Параметр DEVICE позволяет выбрать входной порт аудиокарты. Значение этого параметра по умолчанию 0. Если у аудиокарты портов много, то необходимо указать соответсвуующее выбранному порту значение этого парметра.
Параметр CHUNK - это размер блока сигнала, захватываемого программой за одну итерацию программы.
Параметр WINDOW отвечает за ширину окна программы и количество значений, отображаемых в окне.

7

Параметр FORMAT позволяет выбрать тип данных аудиосигнала. Поддерживаются значения paFloat32, paInt32, paInt24, paInt16, paInt8, paUInt8.
Параметр CHANNELS отвечает количество записываемых каналов. Может принимать значения 1 или 2.
Параметр RATE позволяет выбрать частоту дискретизации входного сигнала в Герцах.

4.4 Spectral parameters

В данном участке кода представлено два параметра:

ORDER
NFFT

Параметр ORDER отвечает за порядок многочлена, который апроксимирует Фурьеспектр сигнала.
Параметр NFFT - размер Фурье спектра по горизонтальной оси.

4.5 Порядок выполнения программы

Сначала создается аудиопоток на основе значений Stream Parameters. Затем на основе параметров GUI создаютсе те элементы UI, которые были выбраны пользователем. В этом участке кода можно также уточнить некоторые особенности отображения формы, такие, как наличие сетки ( plt.grid()) на графике, настройки цвета, количество отображаемых чисел на осях графика. Также можно выбрать границы значений по осям OX и OY для графиков. Также, при необходимости перевести какую-то из осей в логарифмический формат, нужно добавить соответсвенно строчки:

plt.xscale(’log’)
plt.yscale(’log’)

После инициализации формы с задаными настройками запускается функция анимации:

animation = FuncAnimation(fig, update, interval=10)

В параметрах этой функции можно задать временной интервал между кадрами в милисекундах. Функция animation запускает функцию update. Эта функция обновляет график на каждом кадре анимации. Каждый кадр считывается очередной блок аудиосигнала (CHUNK) и на его основе строятся графики, выбранные пользователем. Чтобы построить график спектра Фурье сигнала, в функции spectral_estimate выполняется преобразование фурье. Для этой цели используется библиотека numpy. Чтобы построить апроксимированный многочленом спектр Фурье, выполняется функция lpc_spectrum.

## 5 Заключение

8

## 6 Список литературы

[1] Легочный Фонд России
http://legkie.org
[2] Albert Einstein. Zur Elektrodynamik bewegter K¨orper. (German) [On the electrodynamics of moving bodies]. Annalen der Physik, 322(10):891–921, 1905.
[3] Knuth: Computers and Typesetting, http://www-cs-faculty.stanford.edu/˜uno/abcde.html

9
