tandav/ultrasonic-stethoscope/docs/lungs-model-predz/Predz-31-May-2018.pdf

# Компьютерная модель распространения звука в легких

А. А. Родионов | 1 к маг.
н/р Я. А. Туровский | к. мед. н, доцент

## Цель работы

## Цель работы

- Разработать комп. модель распространения звука в легких.

## Цель работы

- Разработать комп. модель распространения звука в легких.
- Изучить поведение звука, эффекты при различных условиях.

## Задачи работы

## Задачи работы

1. Анализ литературы

## Задачи работы

1. Анализ литературы
2. Основывать модель на реальных данных

## Задачи работы

1. Анализ литературы
2. Основывать модель на реальных данных
3. Математическая модель

## Задачи работы

1. Анализ литературы
2. Основывать модель на реальных данных
3. Математическая модель
4. Компьютерная модель

## Задачи работы

1. Анализ литературы
2. Основывать модель на реальных данных
3. Математическая модель
4. Компьютерная модель
5. Графический интерфейс для управления параметрами модели

## Задачи работы

1. Анализ литературы
2. Основывать модель на реальных данных
3. Математическая модель
4. Компьютерная модель
5. Графический интерфейс для управления параметрами модели
6. Оптимизация модели для SIMD,GPU,CUDA

## Задачи работы

1. Анализ литературы
2. Основывать модель на реальных данных
3. Математическая модель
4. Компьютерная модель
5. Графический интерфейс для управления параметрами модели
6. Оптимизация модели для SIMD,GPU,CUDA
7. Изучение эффектов модели

## Анализ литературы

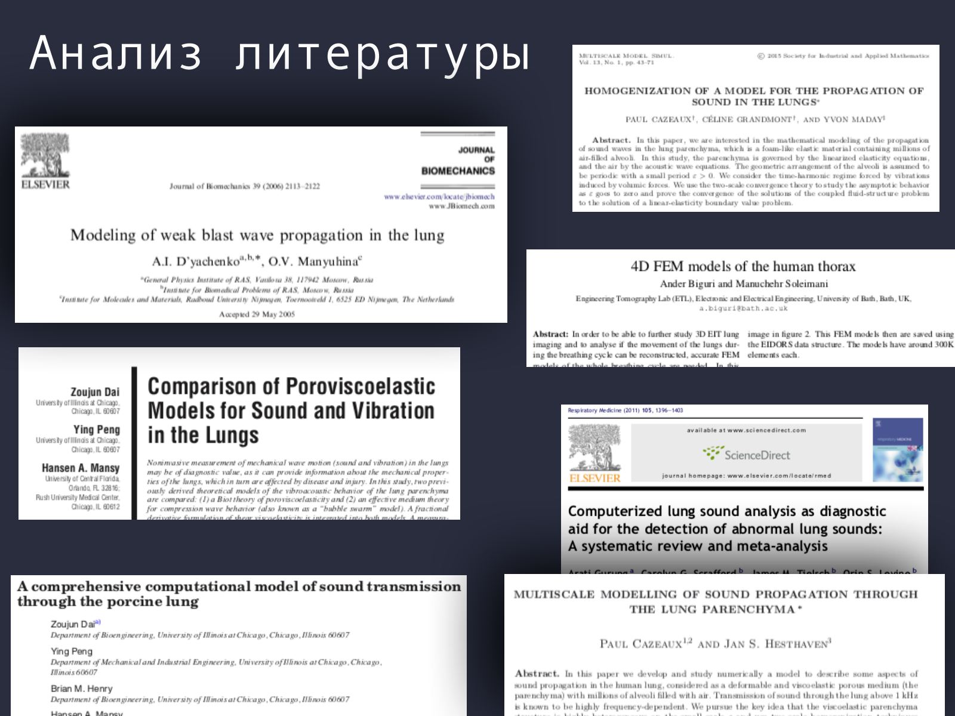
[picture p63: page 13]

## Анализ литературы

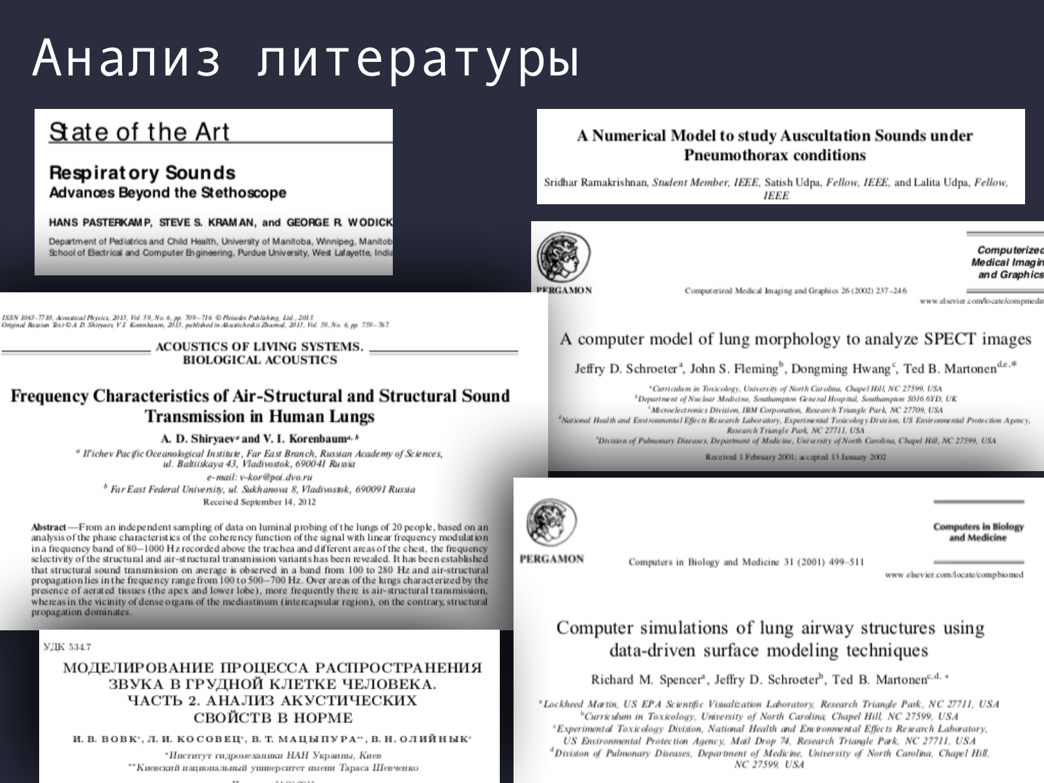
[picture p64: page 14]

## Анализ литературы

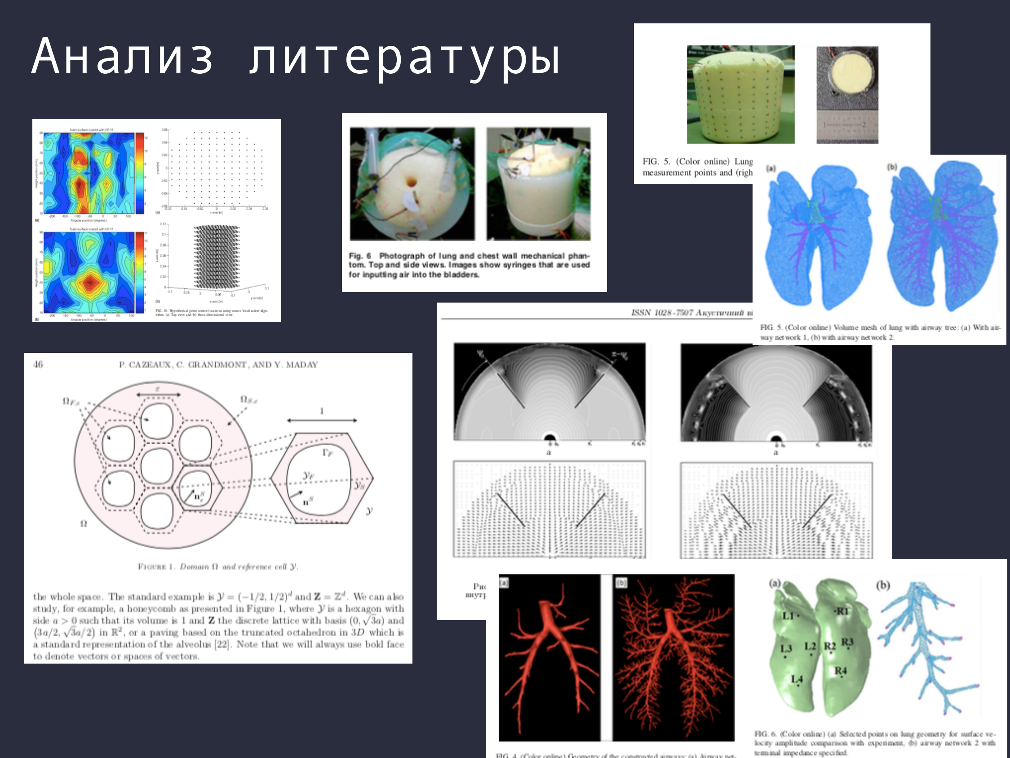
[picture p65: page 15]

## Анализ литературы

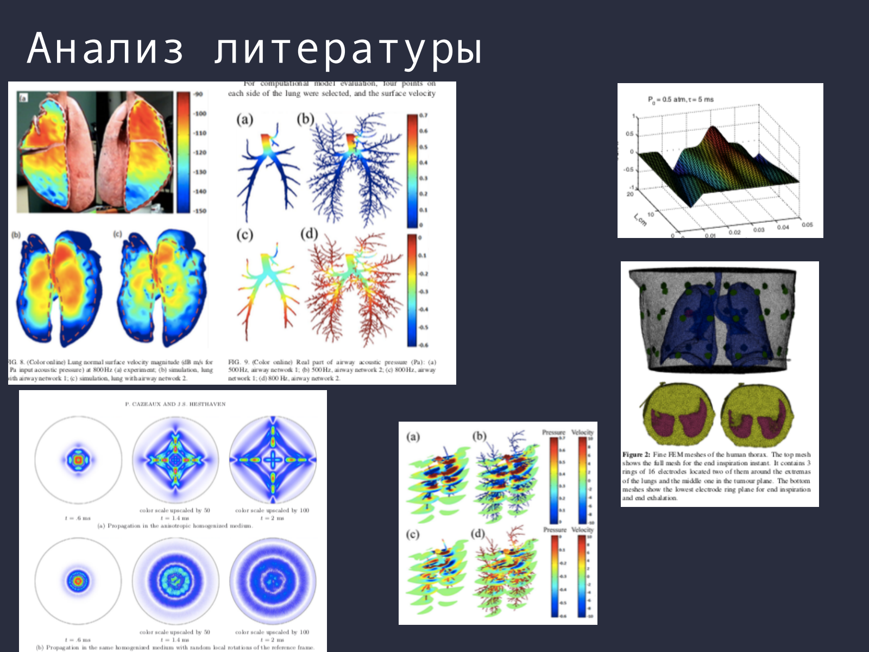
[picture p66: page 16]

## Математическая модель

Предположения
- среда ведет себя как жидкость (80% of body)
- среда неподвижна
- полное отражение на границах

## Математическая модель

p(x, t) - pressure, давление воздуха
ρ(x) | - плотность ткани / мышц
с(x) | - скорость звука
x = [x, y, z] | точка пространства

Волновое уравнение для неоднородной среды

## Математическая модель

Начальные условия

p(x, t=0) = 0 for all x

∂p(x, t) |
———————— | | = 0
∂t | |t=0

## Математическая модель

Начальные условия
p(x, t=0) | = 0 for all x
∂p(x, t) | ———————— | | = 0
∂t | |t=0

Граничные условия (отражения + границы пространства)
p(x, t) = 0 if ρ(x) < 0.1g/cc

## Математическая модель

Начальные условия
p(x, t=0) | = 0 for all x
∂p(x, t) | ———————— | | = 0
∂t | |t=0

Граничные условия (отражения + границы пространства)
p(x, t) = 0 if ρ(x) < 0.1g/cc

Источник звука
p(a,b,c,t) = sin(2πft)
(a,b,c) - положение источника

## Математическая модель

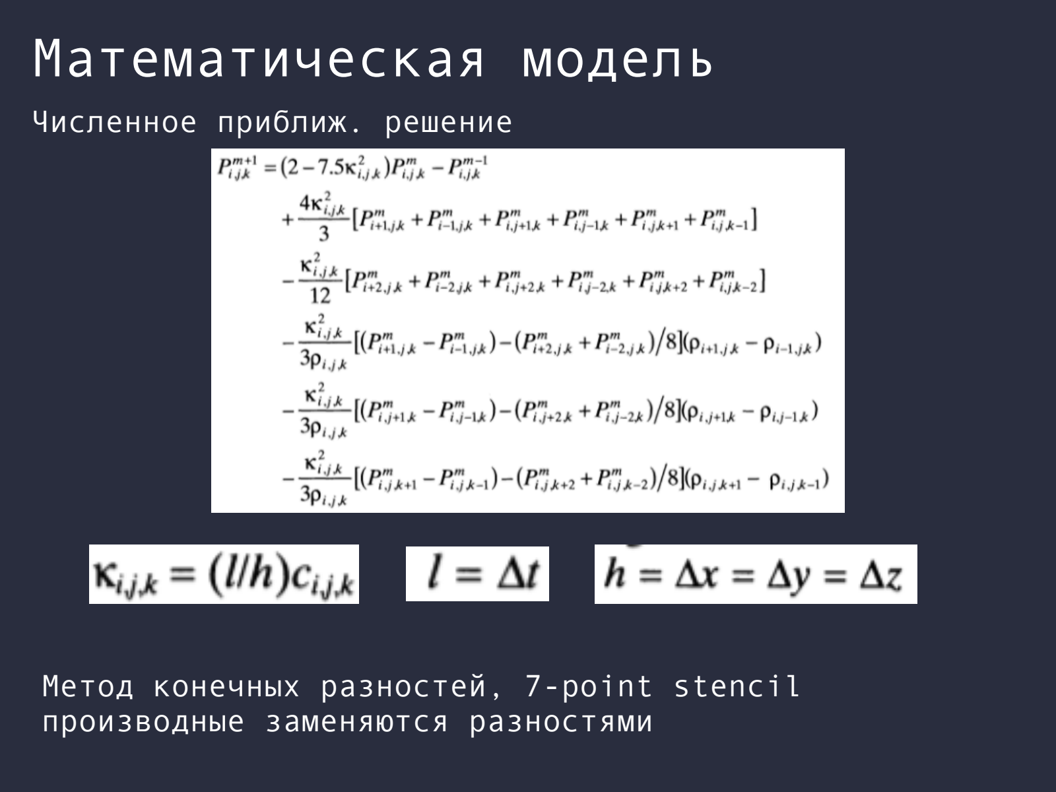
[picture p67: page 22]

Метод конечных разностей, 7-point stencil производные заменяются разностями

Численное приближ. решение

## Математическая модель

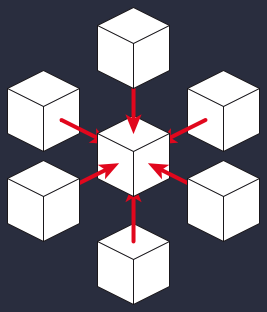
[picture p68: figure]

Численное приближ. решение.

Метод конечных разностей, 7-point stencil производные заменяются разностями

7-point stencil method

## Human Visible Project Dataset

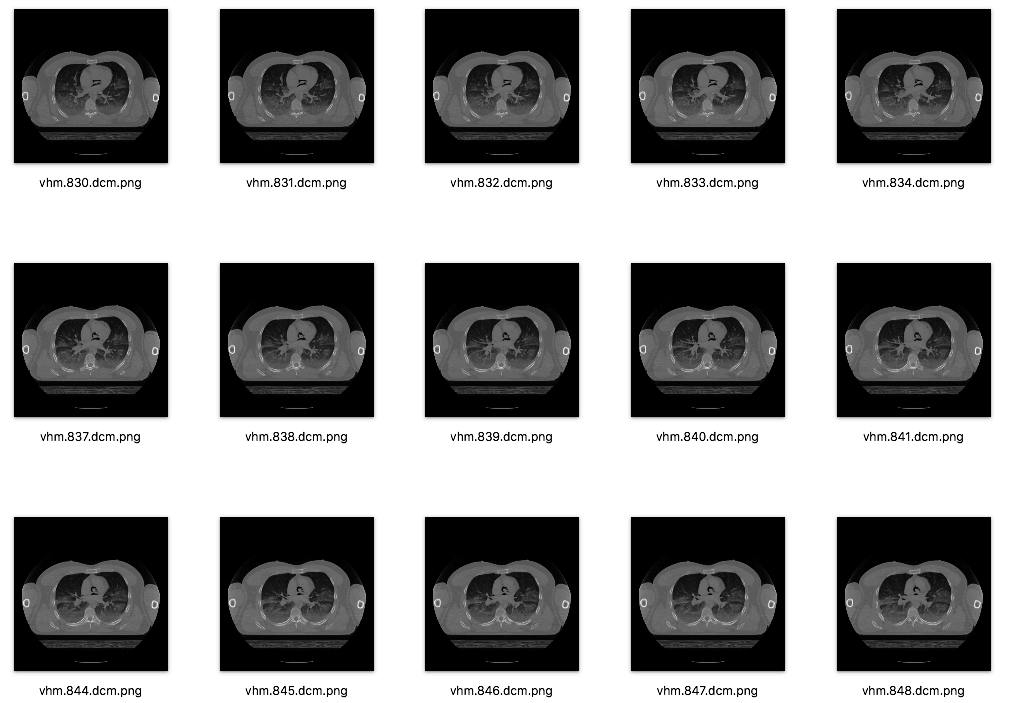
[picture p69: page 24]

## Human Visible Project Dataset

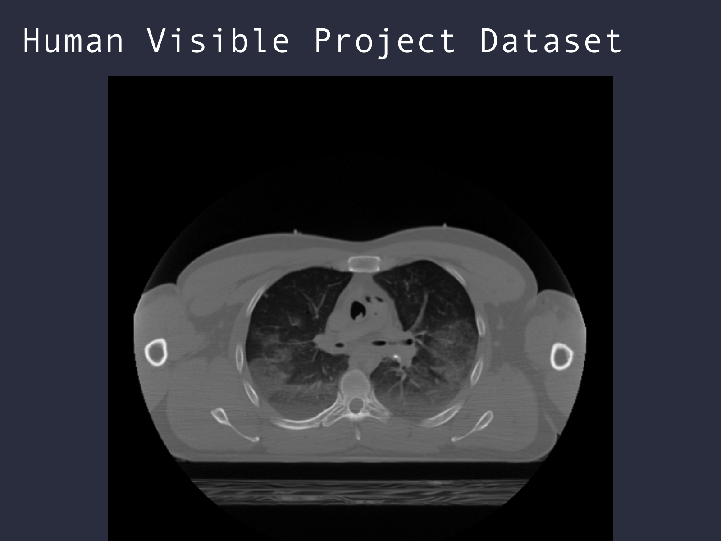
[picture p70: page 25]

## Human Visible Project Dataset

## Human Visible Project Dataset

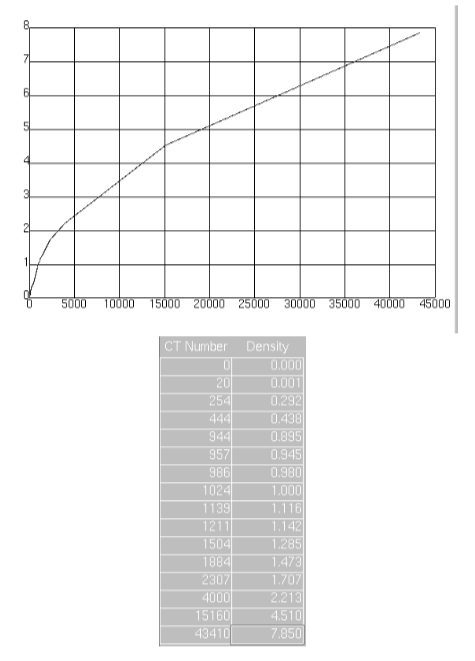
[picture p71: figure]

## Задачи работы

1. Анализ литературы
2. Основывать модель на реальных данных
3. Математическая модель
4. Компьютерная модель
5. Графический интерфейс для управления параметрами модели
6. Оптимизация модели для SIMD,GPU,CUDA
7. Изучение эффектов модели

## Компьютерная модель

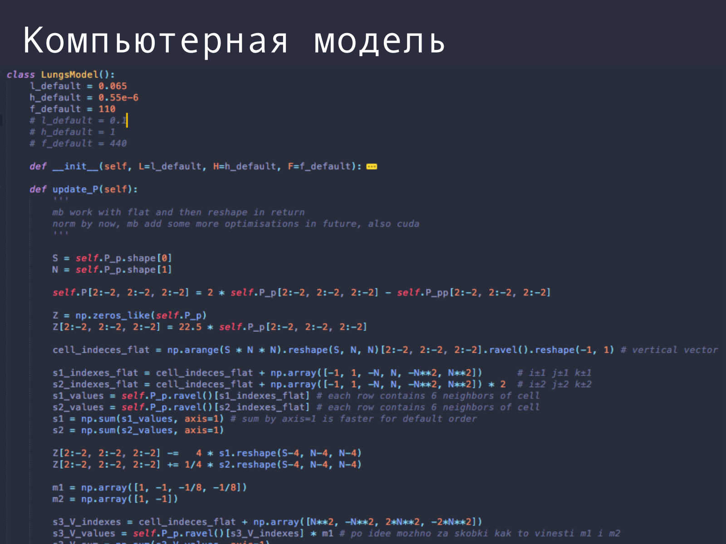
[picture p72: page 29]

## Задачи работы

1. Анализ литературы
2. Основывать модель на реальных данных
3. Математическая модель
4. Компьютерная модель
5. Графический интерфейс для управления параметрами модели
6. Оптимизация модели для SIMD,GPU,CUDA
7. Изучение эффектов модели
