tandav/ultrasonic-stethoscope/arduino-libraries.png

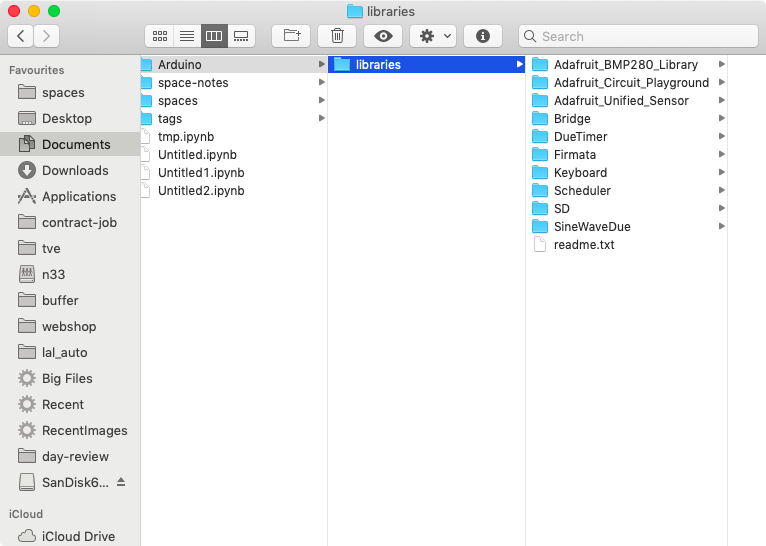
arduino-libraries.png
