tandav/ultrasonic-stethoscope/bmp280/IMG_3220.JPG

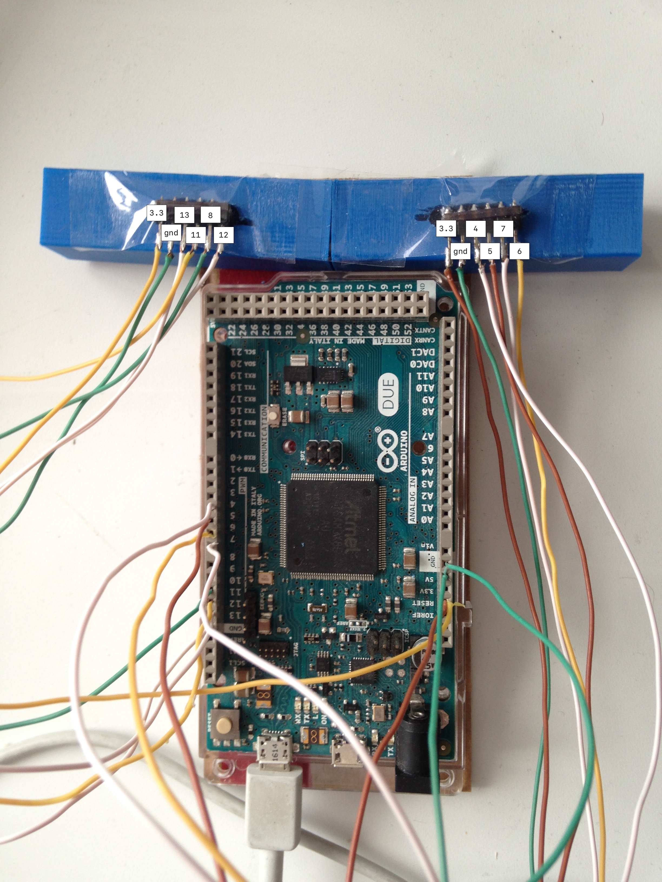
bmp280/IMG_3220.JPG
