tandav/ultrasonic-stethoscope/coherent-accumulation/blueprint.png

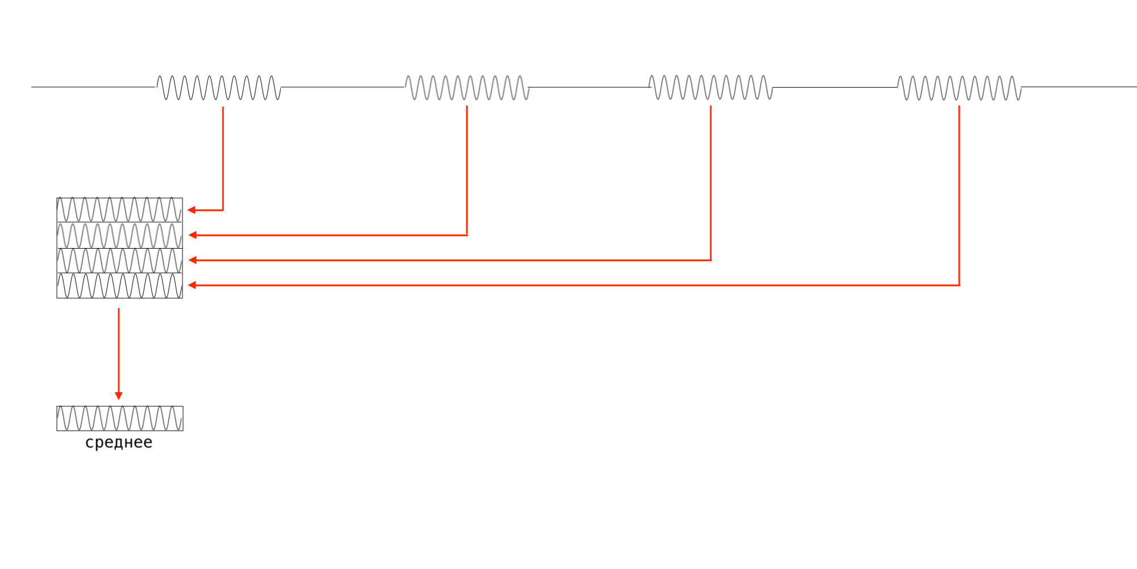
coherent-accumulation/blueprint.png
