tandav/ultrasonic-stethoscope/coherent-accumulation/cancellation.png

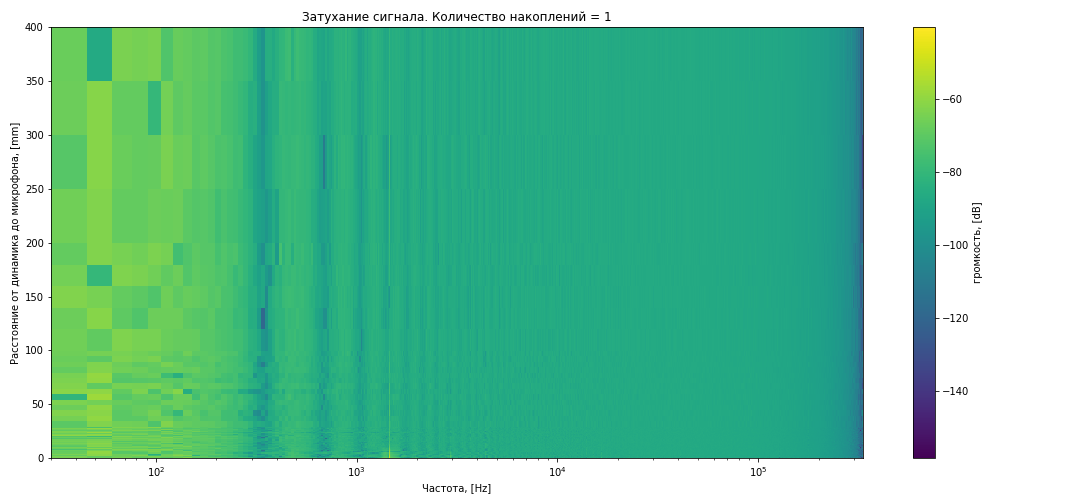
coherent-accumulation/cancellation.png
