tandav/ultrasonic-stethoscope/coherent-accumulation/message.png

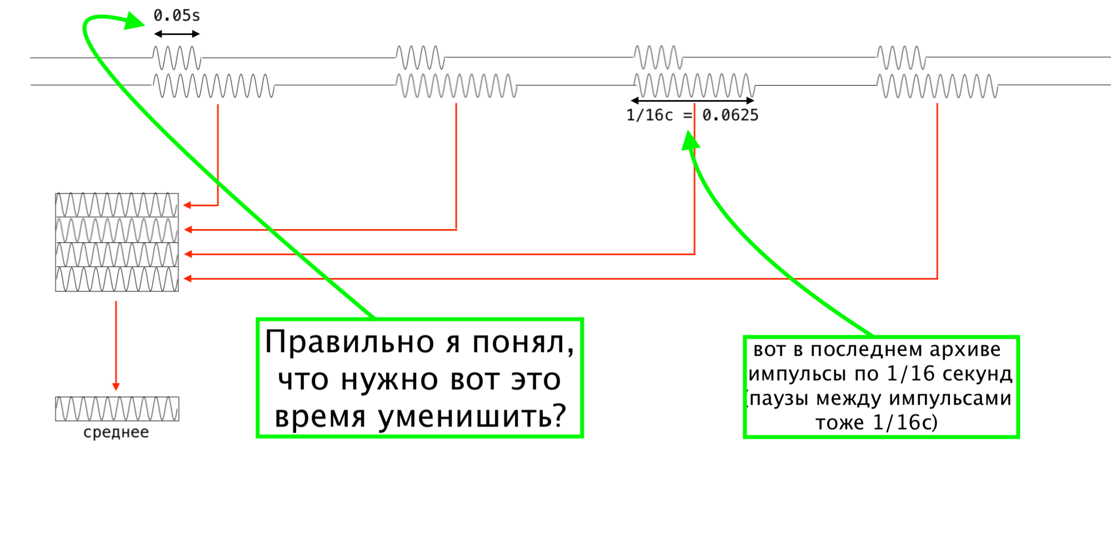
coherent-accumulation/message.png
