tandav/ultrasonic-stethoscope/coherent-accumulation/SineWaveDue-reverse-engineering.png

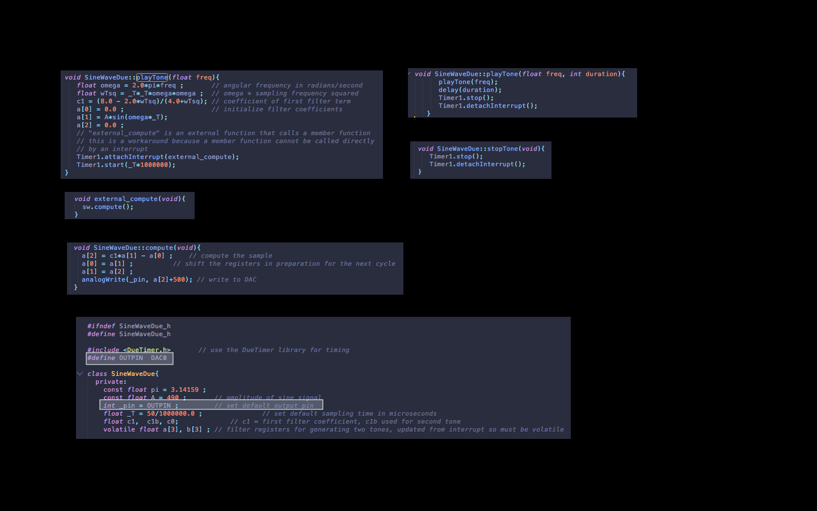
coherent-accumulation/SineWaveDue-reverse-engineering.png
