tandav/ultrasonic-stethoscope/coherent-accumulation/states.JPG

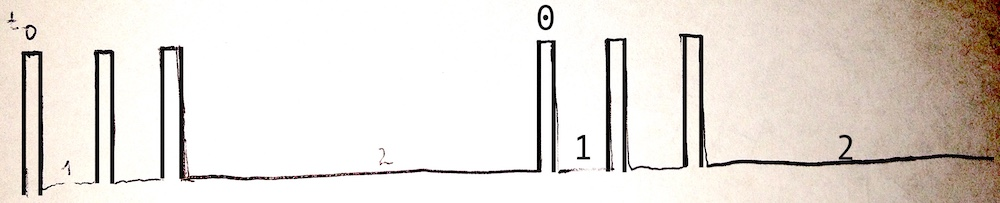
coherent-accumulation/states.JPG
