tandav/ultrasonic-stethoscope/coherent-accumulation/zoom-in/w-o-reset.png

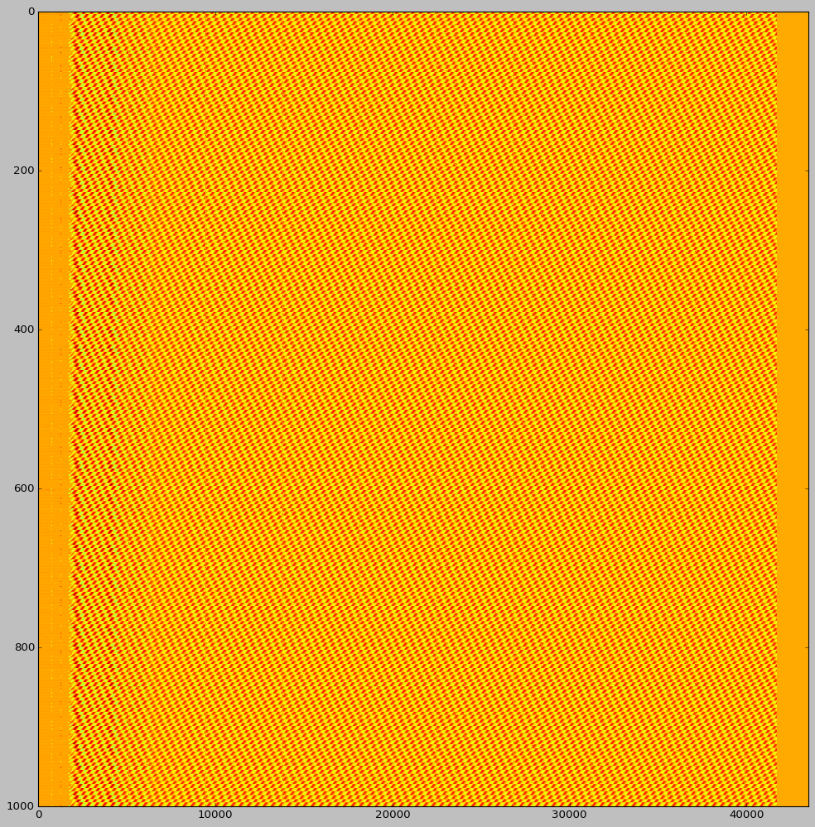
coherent-accumulation/zoom-in/w-o-reset.png
