tandav/ultrasonic-stethoscope/coherent-accumulation/zoom-in/with-reset.png

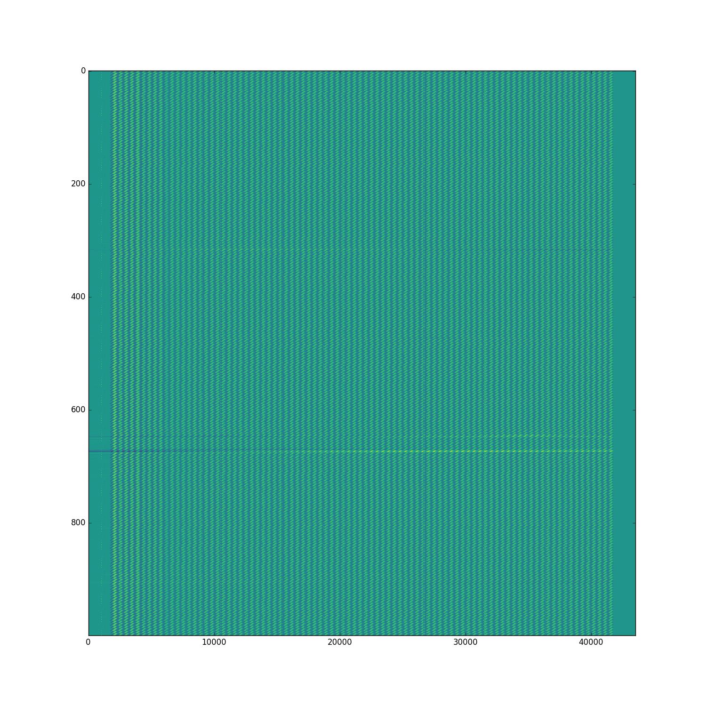
coherent-accumulation/zoom-in/with-reset.png
