tandav/ultrasonic-stethoscope/docs/bachelor-thesis/whitepaper/images/cupy.png

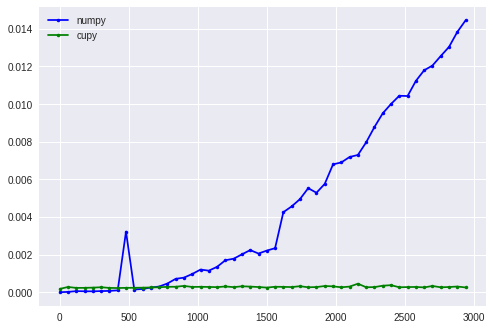
docs/bachelor-thesis/whitepaper/images/cupy.png
