tandav/ultrasonic-stethoscope/docs/lungs-model-predz/Screen Shot 2018-05-31 at 2.01.24 PM.png

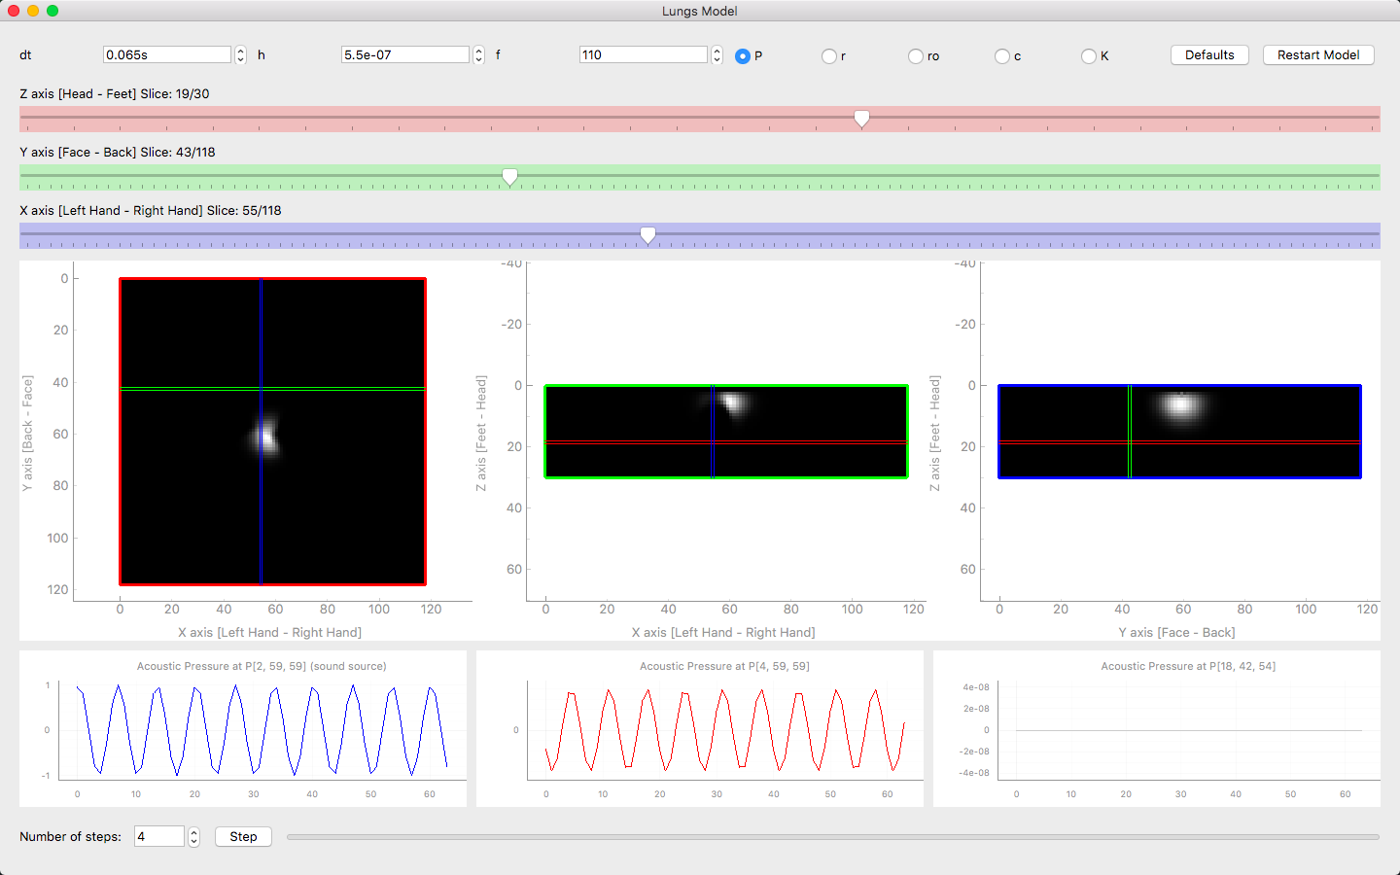
docs/lungs-model-predz/Screen Shot 2018-05-31 at 2.01.24 PM.png
