tandav/ultrasonic-stethoscope/docs/Screen Shot 2018-01-21 at 11.35.50 AM.png

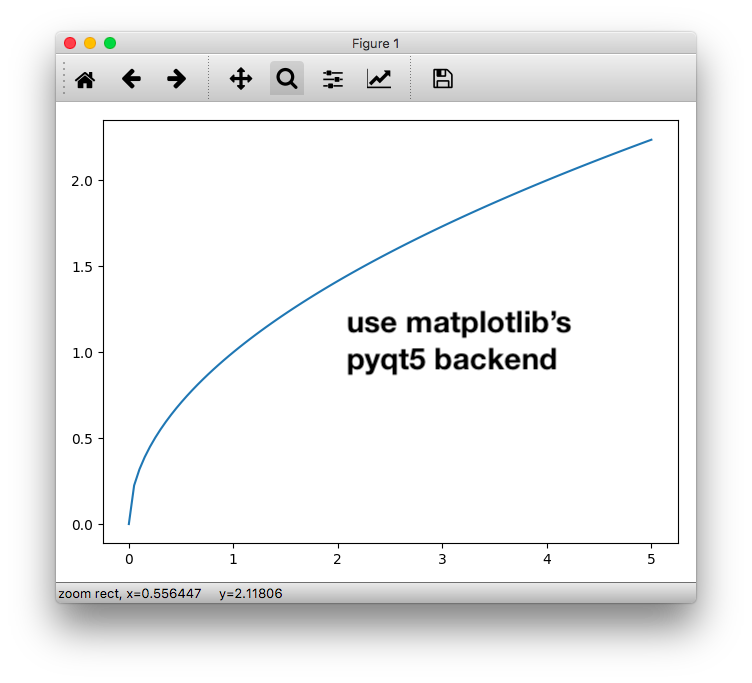
docs/Screen Shot 2018-01-21 at 11.35.50 AM.png
