tandav/ultrasonic-stethoscope/docs/tech/help-screens/currrent-colormap.png

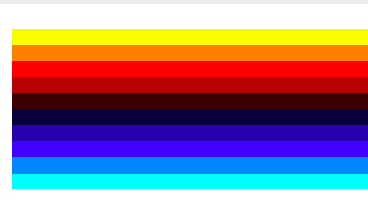
docs/tech/help-screens/currrent-colormap.png
