tandav/ultrasonic-stethoscope/docs/tech/help-screens/Screen Shot 2017-09-01 at 2.30.02 PM.png

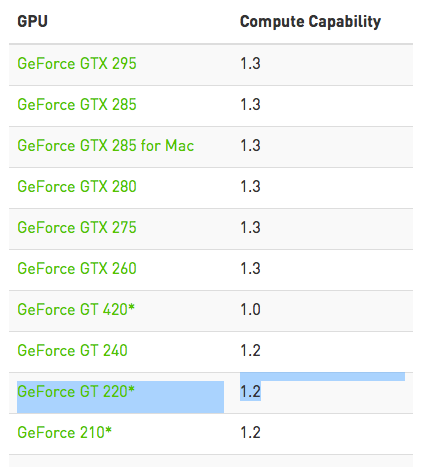
docs/tech/help-screens/Screen Shot 2017-09-01 at 2.30.02 PM.png
