tandav/ultrasonic-stethoscope/docs/tech/help-screens/Screen Shot 2017-09-02 at 6.58.51 AM.png

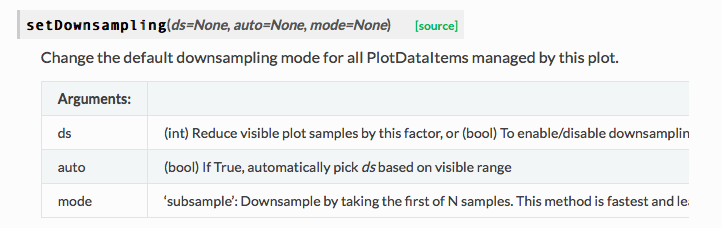
docs/tech/help-screens/Screen Shot 2017-09-02 at 6.58.51 AM.png
