tandav/ultrasonic-stethoscope/docs/tech/help-screens/Screen Shot 2017-09-05 at 2.12.52 PM.png

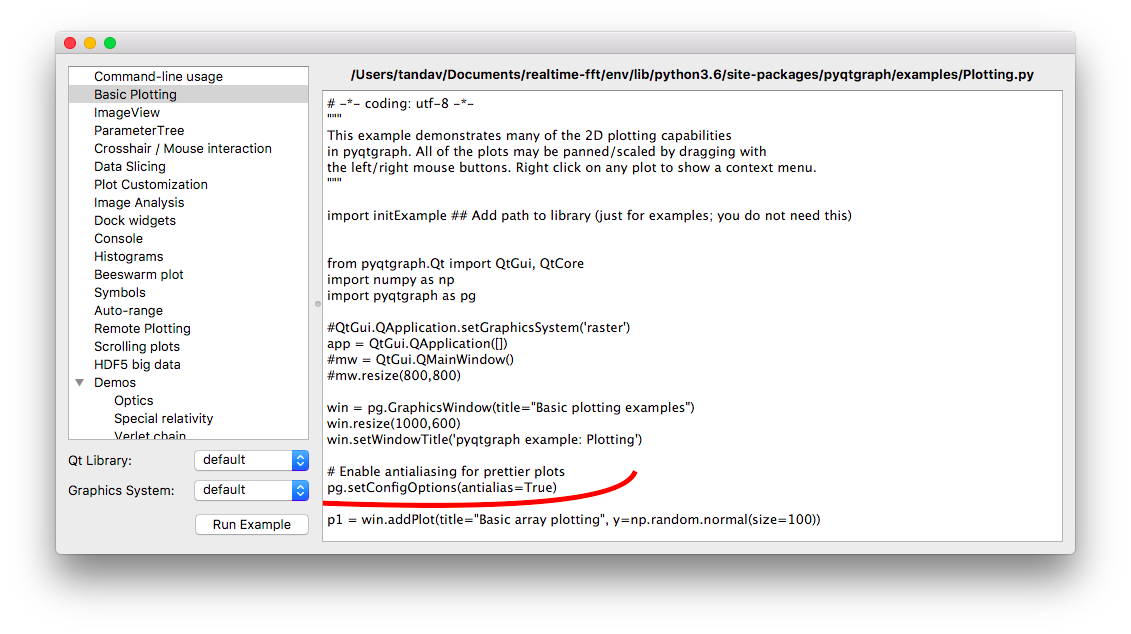
docs/tech/help-screens/Screen Shot 2017-09-05 at 2.12.52 PM.png
