tandav/ultrasonic-stethoscope/docs/tech/help-screens/Screen Shot 2017-09-16 at 7.38.27 PM.png

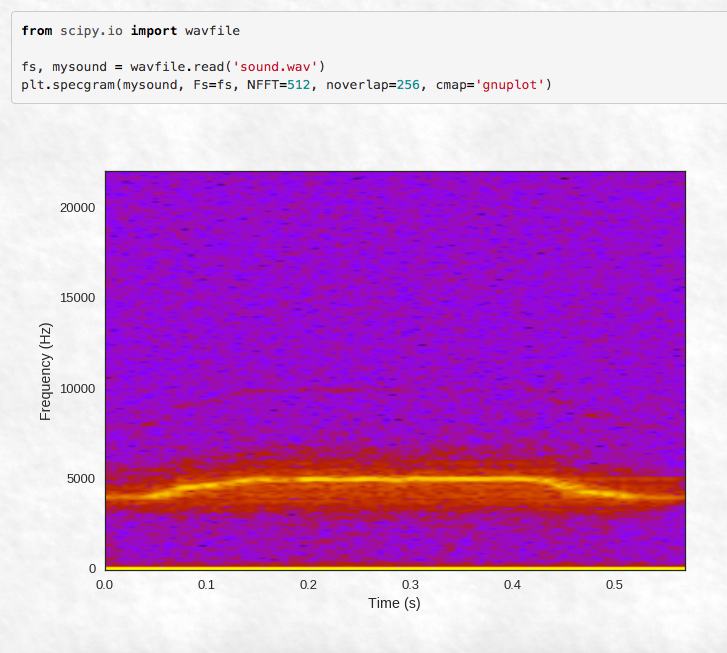
docs/tech/help-screens/Screen Shot 2017-09-16 at 7.38.27 PM.png
