tandav/ultrasonic-stethoscope/docs/tech/help-screens/Screen Shot 2017-09-28 at 8.17.02 AM.png

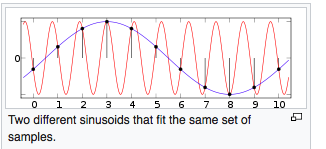
docs/tech/help-screens/Screen Shot 2017-09-28 at 8.17.02 AM.png
