tandav/ultrasonic-stethoscope/lungs-model/fdtd/normal-chest-ct-lung-window-1.jpg

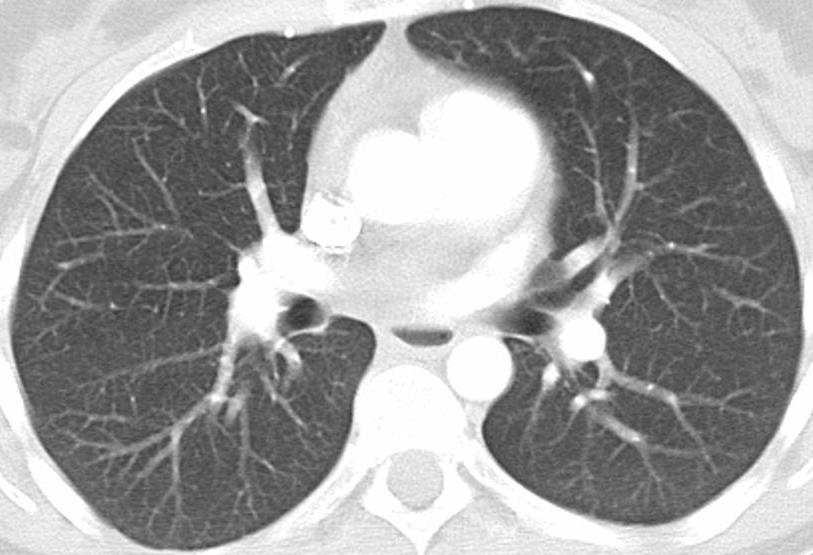
lungs-model/fdtd/normal-chest-ct-lung-window-1.jpg
