tandav/ultrasonic-stethoscope/lungs-model/main/slices.png

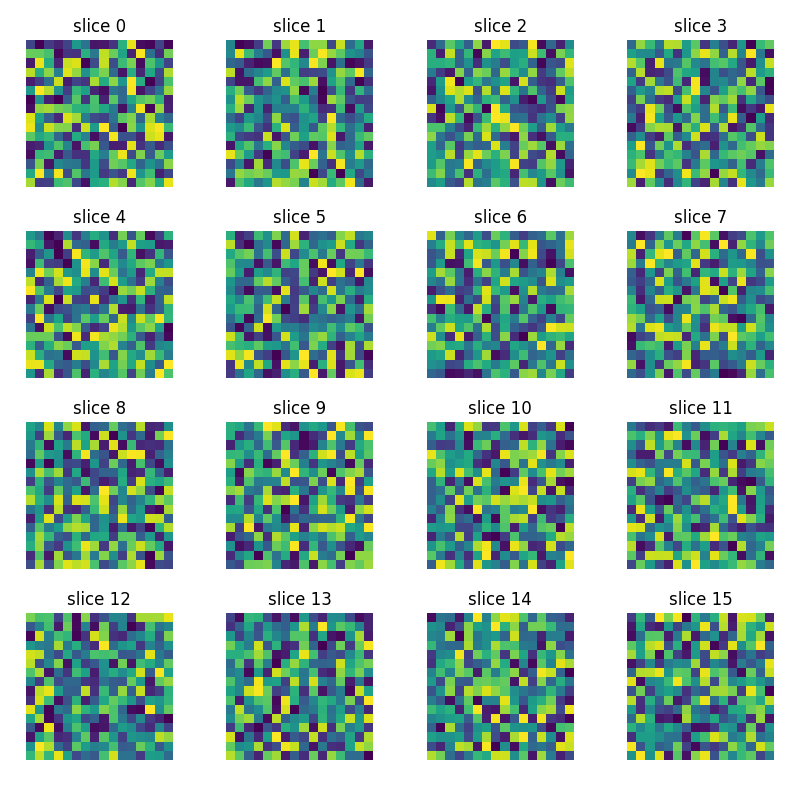
lungs-model/main/slices.png
