tandav/ultrasonic-stethoscope/lungs-model/math/7-point 3D stencil.png

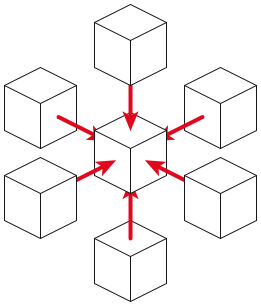
lungs-model/math/7-point 3D stencil.png
