tandav/ultrasonic-stethoscope/lungs-model/math/nabla-pde.png

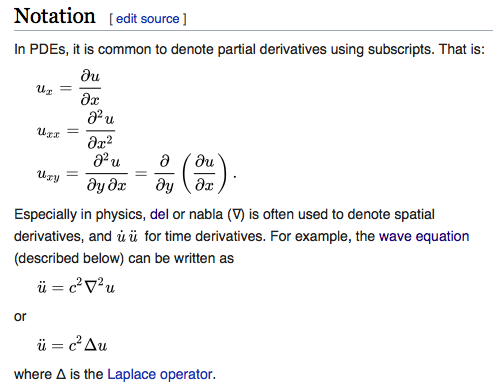
lungs-model/math/nabla-pde.png
