tandav/ultrasonic-stethoscope/lungs-model/Screen Shot 2018-04-15 at 1.13.45 PM.png

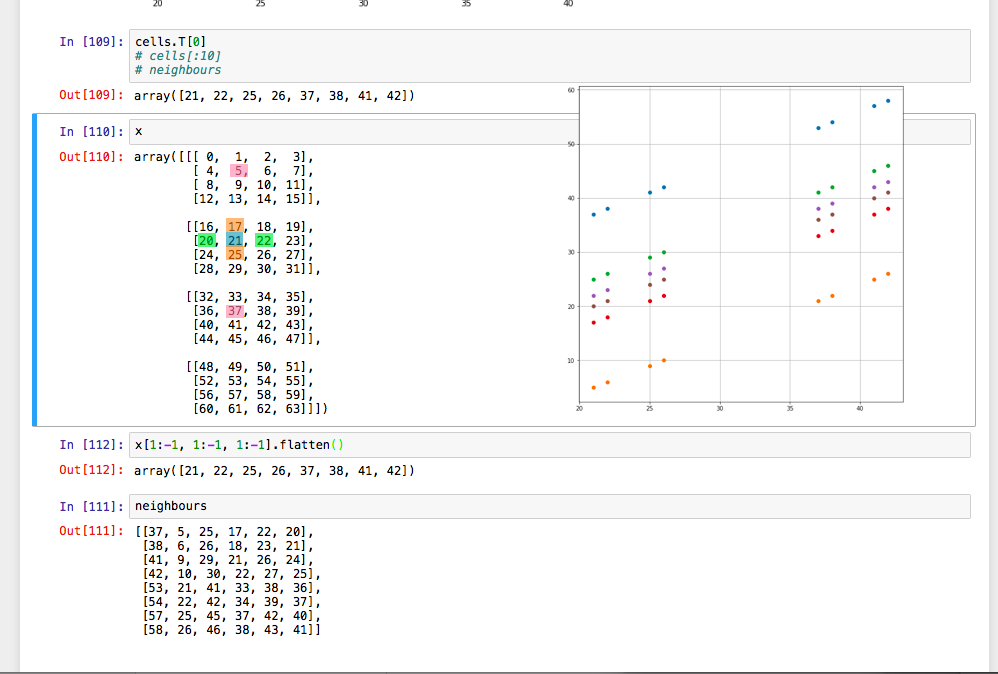
lungs-model/Screen Shot 2018-04-15 at 1.13.45 PM.png
