tandav/ultrasonic-stethoscope/lungs-model/Screen Shot 2018-04-15 at 3.08.54 PM.png

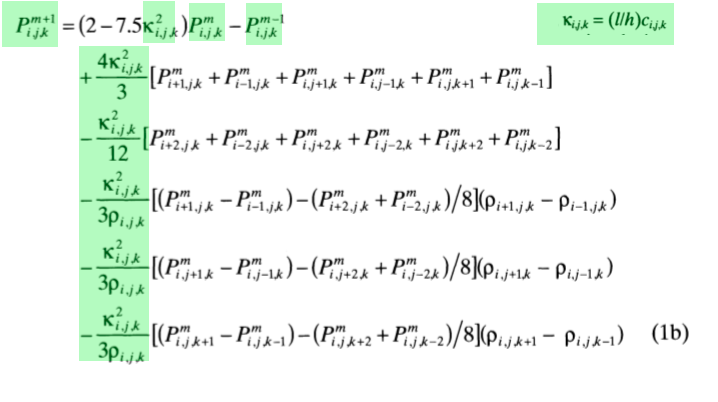
lungs-model/Screen Shot 2018-04-15 at 3.08.54 PM.png
