tandav/ultrasonic-stethoscope/Screenshot 2016-03-05 14.14.25.png

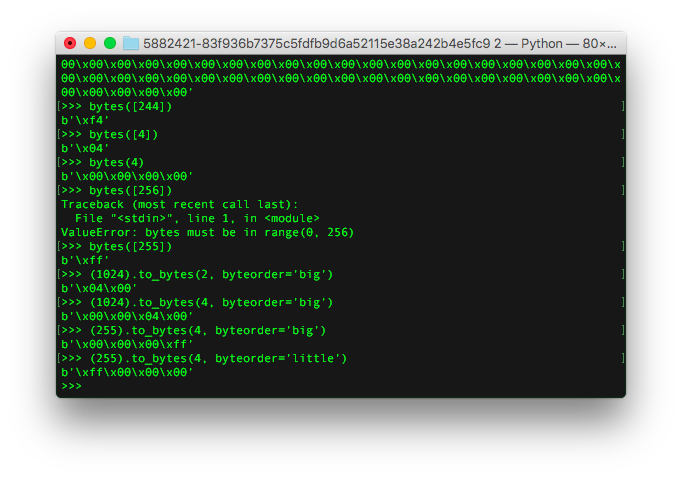
Screenshot 2016-03-05 14.14.25.png
