tandav/ultrasonic-stethoscope/docs/tech/help-screens/FPS test.png

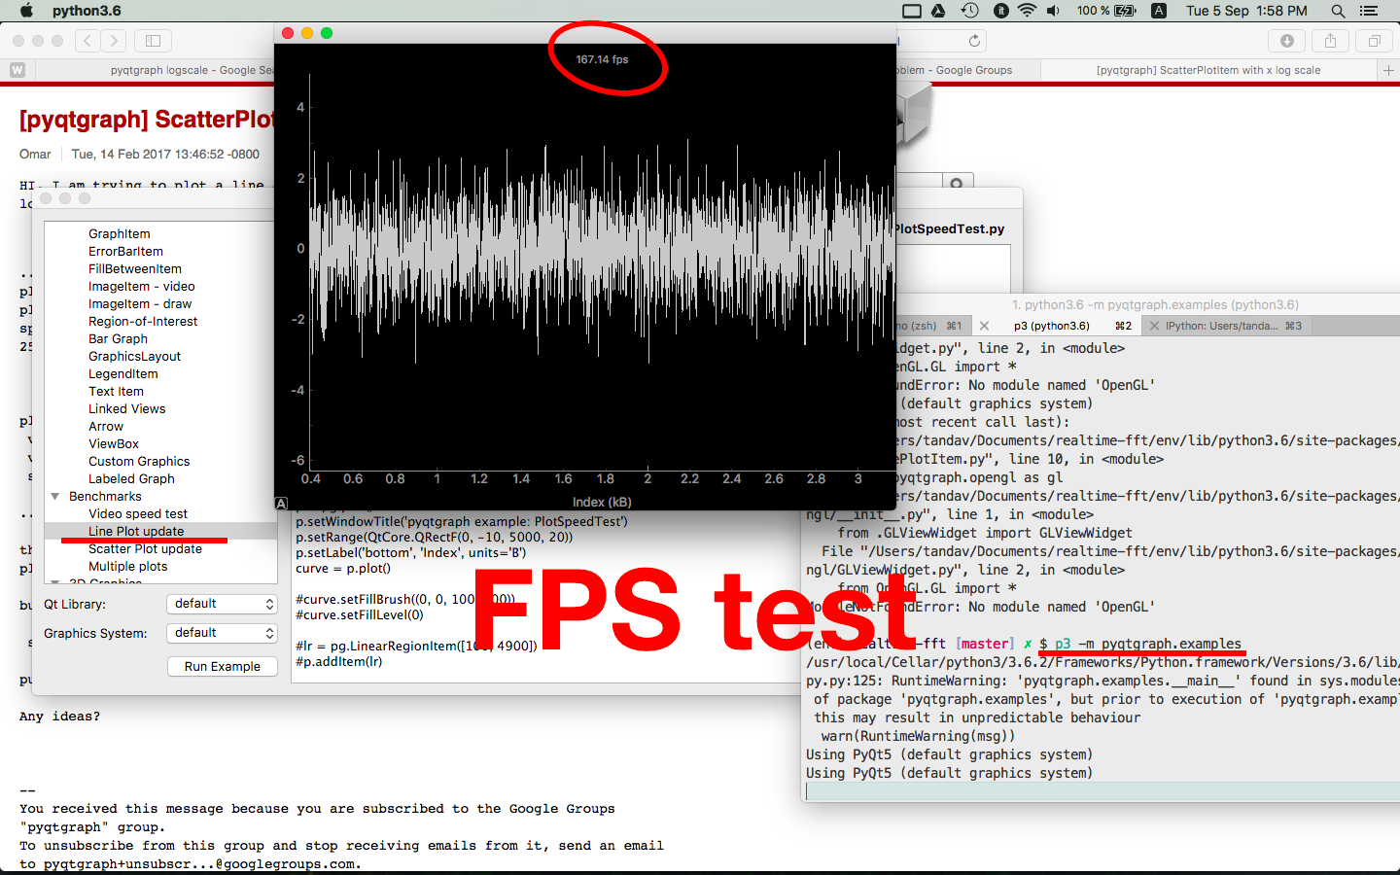
docs/tech/help-screens/FPS test.png
