tandav/ultrasonic-stethoscope/docs/tech/problems.md

# Possible Problems

RuntimeError: Python is not installed as a framework. The Mac OS X backend will not be able to function correctly if Python is not installed as a framework. See the Python documentation for more information on installing Python as a framework on Mac OS X. Please either reinstall Python as a framework, or try one of the other backends. If you are using (Ana)Conda please install python.app and replace the use of 'python' with 'pythonw'. See 'Working with Matplotlib on OSX' in the Matplotlib FAQ for more information.

- `SOLVED` [macos - matplotlib: RuntimeError: Python is not installed as a framework - Stack Overflow](https://stackoverflow.com/questions/34977388/matplotlib-runtimeerror-python-is-not-installed-as-a-framework)

---
