tandav/ultrasonic-stethoscope/(threads)

Thread 1 (2016-10-14):

На выходные работка

tandav, 2016-10-14:
- [x] 3 графика - 2 с термодатчиков (каждый отдельно) и один c микрофона
- [x] скользящее среднее добавить
- [x] все-таки наверное через таймер-тик делать, потому что несколько графиков будет.

# C# sound visualisation
### Useful Links
- [Autotune.NET – Russian Coding 4 Fun](https://blogs.msdn.microsoft.com/rucoding4fun/2011/02/22/autotune-net/)
- [How to Draw Waveform While Recording Using NAudio and WPF | Assemble Force](http://www.assembleforce.com/2012-07/how-to-draw-waveform-while-recording-using-naudio-and-wpf.h)
- [Trying to understand buffers with regard to NAudio in C# - Stack Overflow](http://stackoverflow.com/questions/37148997/trying-to-understand-buffers-with-regard-to-naudio-in-c-sharp)
- [Plotting Waveforms FROM .WAV FILE - YouTube](https://www.youtube.com/watch?v=ZnFoVuOVrUQ)
- Unity (see that framework)
- <https://channel9.msdn.com/coding4fun/articles/NET-Voice-Recorder>
- [naudio display waveform - Google Search](https://www.google.ru/search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)
- [Highest Voted 'naudio' Questions - Stack Overflow](http://stackoverflow.com/questions/tagged/naudio?sort=votes&pageSize=15)
- [c# visualize audio - Google Search](https://www.google.com/search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)
- [c# - Record input from NAudio WaveIn, and output to NAudio WaveOut - Stack Overflow](http://stackoverflow.com/questions/5694326/record-input-from-naudio-wavein-and-output-to-naudio-waveout)
- [How to convert between (most) audio formats in .NET - CodeProject](http://www.codeproject.com/Articles/501521/How-to-convert-between-most-audio-formats-in-NET)
- [audio - What do the bytes in a .wav file represent? - Stack Overflow](http://stackoverflow.com/questions/13039846/what-do-the-bytes-in-a-wav-file-represent)
- [naudio waveform - Google Search](https://www.google.com/search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)

mb fake
16 bits = 2 bytes (diveded by 8)

<http://stackoverflow.com/questions/13248500/microphone-buffer-in-naudio-c-sharp>

типа по 2 байта как-то походу они аля 2 байта инфы - следующие 2байта инфы.

## Done
- [x] Python -> .NET transition (mic visualisation)
  - [x] ❗️**NB** Try to del timer and do all on event handler
- [x] <https://github.com/filoe/cscore>
- [x] <https://github.com/naudio/NAudio>
    - [x] [.NET Voice Recorder - Home](http://voicerecorder.codeplex.com/)
- [x] - [Easy way to plot graphs with C#](https://codeabout.wordpress.com/2011/05/15/easy-way-to-plot-graphs-in-c-and-visual-studio-2010/)

tandav, 2016-10-21:
mb fake
16 bits = 2 bytes (diveded by 8)

<http://stackoverflow.com/questions/13248500/microphone-buffer-in-naudio-c-sharp>

tandav, 2016-10-24:
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

tandav, 2016-10-25:
# Bogat additions
1. Если регулировать то если usb снизу то вот этот резистор (1)
```
01
00
```

2. 2 белых - это одно, 2 черных -другое
3. В идеале дышать а так вообще трогать - спай наверное.
4. Вот допустим взять 2 белых. Там короче юзать только один, а другой - он сбивает. В идеале ничто ни должно ни на что влиять - все четыре должны быть разнесены друг от друга.
5.  Вот допустим взять 2 белых. Один - меряет изменения, а второй - контрольный, чтобы не зависело от температуры в комнате - он должен просто в воздухе быть и не подвергаться нагреву.

tandav, 2016-10-28:
Data_Available мы получаем с микрофона каждые 10 мс буффер звуковых данных в 1600 байт.

Closed 2016-10-29.

Thread 2 (2016-10-20):

First seconds dont shows properly

tandav, 2016-10-20:
x-axis shift shrinks chart in the first several seconds. Need to fix.

tandav, 2016-10-29:
use Queue data structure

Closed 2016-10-29.

Thread 3 (2016-10-24):

частота дискретизации != количество точек по x-axis на графике

tandav, 2016-10-24:
# NB
Короче подстраивай n_mic и k - чтобы получить что нужно турику

- [ ] протестить всегда ли 1600 на windows-pc. Мб это - какие-то ограничения virtual machine (parallels)
- Also see [naudio 1600 - Google Search](https://www.google.com/search?q=naudio+1600&oq=naudio+1600&aqs=chrome..69i57.6939j0j7&sourceid=chrome&ie=UTF-8)

e.ButesRecorded = 1600 всегда.
e.Buffer.Length = 1600 всегда.
Мб каждые 10ms

```cs
byte[] buffer = ...; // e.Buffer
for(int n = 0; n < buffer.Length; n+=2)
{
   short sample = BitConverter.ToInt16(buffer, n);
}
```

В [этой](http://mark-dot-net.blogspot.ru/2013/03/how-to-convert-byte-to-short-or-float.html) статье вроде Wavebuffer самый крутой

Короче потом эту оптимизацию сделать. Сейчас похуй пока BitConverter юзать

Но вот что тогда дает частота дискретизации

For a given sample rate, bit depth, and channel count, PCM audio always has the same bitrate (calculated by multiplying those three values together). If you want to reduce the bitrate, you must change one of those three (lowering the sample rate is probably the best option unless you can go from stereo to mono).

Частота дискретизации должна быть больше и отрисовывать **скользящее среднее**. Отрисовывать по дехе точке ну там 512 допустим

tandav, 2016-10-31:
В методе Data_Available мы получаем с микрофона каждые 10 мс буффер звуковых данных в 1600 байт. Тут можно либо сразу передавать этот буфер в функцию автокорреляции, либо помещать добавлять буфер в какой-нибудь список, а затем этот список подвергать автокорреляции.

tandav, 2016-10-31:
up vote
1
down vote
NAudio will calculate the bit rate for you, if you provide sample rate and channels in the WaveFormat constructor with two parameters. (you can also specify bit depth, but this will normally be 16).

You can specify any sample rate you like, but if you want to play it easily in Windows, go for a standard value (e.g. 44100, 32000, 48000, 16000).

tandav, 2016-10-31:
убрать квадраты при сглаживании. Это потому что разные dataavailable  не ровный стык у них

tandav, 2016-11-01:
```cs
wl = window.Length
int s = 0;

for(int i = 0; i < wl; i++)
{
	if (i < wl - 1)
	{
		for(int j = e.BytesRecorded - wl + 1 + i; j < e.BytesRecorded; j++)
		{
			s += da_prev[j];
		}
		s += da_curr[i];
	}
	else
	{

	}
}
```

tandav, 2016-11-01:
мб foreach добавить где-то

Closed 2016-11-02.

Thread 4 (2016-10-31):

просачиваются данные с одного сенсора на другой

tandav, 2016-10-31:
# WTF

походу там аля остаточное напряжение на ADC остается после прошлого сенсора, даже если на него уже перезаписал.

dt=100ms, -> 16000 Bytes/s * 8 = 128000 Bytes / s
# To Do
1. - [x] засечь dt между двумя вызовами DataAvailable(). В среднем dt = 100ms

Closed 2016-11-17.

Thread 8 (2017-02-05):

Rudshel ADC

tandav, 2017-02-05:
## Todo
- [x] make console app, where data prints by timer not by `ReadKey()`
- [x] fork KernelChip  program (GUI) and make it work w/ new adc

## Tips / btw
- put dll into `/bin/Debug/` Хз, пока не разобрался с этим дерьмом. Если из других папок - то не подключается. Даже если из ` /bin/Debug/`, то выдаст ошибку, но работать будет
    - [for future debugging](http://stackoverflow.com/questions/9003072/unable-to-load-dll-module-could-not-be-found-hresult-0x8007007e)
- `timer.enabled = true` is the same thing as `timer.Start()`. Use second option for certainity. [more info](https://social.msdn.microsoft.com/Forums/vstudio/en-US/03e83a93-652f-4559-ba9e-f397b1755ad7/timerenabled-vs-timerstartstop-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)
- do not confuse Timer and Stopwatch

Closed 2017-02-18.

Thread 9 (2017-02-18):

implementing moving average (aka running mean)

tandav, 2017-02-18:
Короче, суть такая, что **сохраняю все значения, сколько их получилось из `running_mean` при заданном `running_mean_window_size`**. Это или list, в который аппендятся значения и в конце `timerTick()` обнуляются. (`len(list) == 0`). Или array, который заранее инициализируется и его длина тоже просчитывается вручную или по формуле заранее.

Важное замечание: количество значений при скользящем среднем равно исходному количеству значений. (buffer_size)

Отрисовка этого дерьма на экране - это вообще другая сущность. Создается другой array/queue/list, в который "просеиваются" значения из листа значений. Можно фулл отрисовывать сколько есть, можно через 1/через 2 итд, короче чтобы комп не тормозил и нужная детализация была.

tandav, 2017-02-18:
Сравнить с моим вариантом

Closed 2017-02-19.

Thread 11 (2017-03-05):

Add new data directly to chart

tandav, 2017-03-05:
Actually you don't need special Queue or List to store data. You can append and remove it from the very chart.
- [VS2010 WinForms C# Chart - How to Dynamically Update a Chart in a Single Iteration Loop?](https://social.msdn.microsoft.com/Forums/windows/en-US/df3c3897-cb4b-48e5-bc0e-4bca6402dc1d/vs2010-winforms-c-chart-how-to-dynamically-update-a-chart-in-a-single-ite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)
- вообще когда один раз забиндил дату - нужно юзать `chart1.Uptate()`
  - **try this option in separate project**

tandav, 2017-03-17:
```cs
chart1.Series[0].Points.DataBindY(values_to_draw);
```
Это нормальный по скорости варик, вообще я глубоко гуглил и вроде всякие DataBind Sources - не особо лучше, скорее всего вот как сейчас лучший варик. Ну и вообще инфа по этому вопросу старая из 2010х на stackowerflow.

Closed 2017-03-17.

Thread 12 (2017-03-06):

Axes fine tuning. It should show real voltage

tandav, 2017-03-06:
Do it when I near generator. Seems like values oscillating around `-2V`(should be `0V`)

tandav, 2017-03-17:
Младший значащий разряд (МЗР)
Least significant bit (LSB)
Минимальное входное напряжение разрешаемое АЦП. Для АЦП с числом N значащих разрядов в выходном регистре значение МЗР равно отношению максимального размаха входного напряжения АЦП к 2N. Измеряется в [В]

tandav, 2017-03-17:
Короче там походу неправильно преобразуется из этих МЗР в вольты. Попробывать получать данные в мзр и самому преобразовывать в вольты.

tandav, 2017-05-19:
Rudshel-ADC support has been dropped

Closed 2017-05-19.

Thread 19 (2017-05-22):

Maybe TODO

tandav, 2017-05-22:
- Make Rudshel ADC data visualisation boilerplate as separate repo?

# UX improvements
- [x] Create a loop with timeout that tries to connect to arduino. (to prevent `could not open serial port` error)
- [x] Fix thread issue, which forces you to reboot arduino after each run of the app.
- [x] Print length of recorded signal in seconds
- [ ] change rudshel project name

Closed 2017-05-30.

Thread 21 (2017-08-10):

nicer argv

tandav, 2017-08-10:
it should be much simpler:

```py
import sys

for i in sys.argv:
    print(i)
```
than
https://github.com/tandav/ultrasonic-stethoscope/blob/627bfe7efdde37e5a642dc237c07fab90518809f/arduino/app.py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

- [Argparse Tutorial — Python 3.7.0a0 documentation](https://docs.python.org/3.7/howto/argparse.html)
- [optparse vs argparse - Google Search](https://www.google.ru/search?q=optparse+vs+argparse) `TLDR: use argparse, optparse is deprecated`

Closed 2017-09-08.
