tandav/ultrasonic-stethoscope/(list of files, drawings)

Other design files:
docs/tech/Circuit/Amplifier.lay6
