tandav/ultrasonic-stethoscope/tools/viridis.py

viridis_data = [[0.267004, 0.004874, 0.329415],
                [0.268510, 0.009605, 0.335427],
                [0.269944, 0.014625, 0.341379],
                [0.271305, 0.019942, 0.347269],
                [0.272594, 0.025563, 0.353093],
                [0.273809, 0.031497, 0.358853],
                [0.274952, 0.037752, 0.364543],
                [0.276022, 0.044167, 0.370164],
                [0.277018, 0.050344, 0.375715],
                [0.277941, 0.056324, 0.381191],
                [0.278791, 0.062145, 0.386592],
                [0.279566, 0.067836, 0.391917],
                [0.280267, 0.073417, 0.397163],
                [0.280894, 0.078907, 0.402329],
                [0.281446, 0.084320, 0.407414],
                [0.281924, 0.089666, 0.412415],
                [0.282327, 0.094955, 0.417331],
                [0.282656, 0.100196, 0.422160],
                [0.282910, 0.105393, 0.426902],
                [0.283091, 0.110553, 0.431554],
                [0.283197, 0.115680, 0.436115],
                [0.283229, 0.120777, 0.440584],
                [0.283187, 0.125848, 0.444960],
                [0.283072, 0.130895, 0.449241],
                [0.282884, 0.135920, 0.453427],
                [0.282623, 0.140926, 0.457517],
                [0.282290, 0.145912, 0.461510],
                [0.281887, 0.150881, 0.465405],
                [0.281412, 0.155834, 0.469201],
                [0.280868, 0.160771, 0.472899],
                [0.280255, 0.165693, 0.476498],
                [0.279574, 0.170599, 0.479997],
                [0.278826, 0.175490, 0.483397],
                [0.278012, 0.180367, 0.486697],
                [0.277134, 0.185228, 0.489898],
                [0.276194, 0.190074, 0.493001],
                [0.275191, 0.194905, 0.496005],
                [0.274128, 0.199721, 0.498911],
                [0.273006, 0.204520, 0.501721],
                [0.271828, 0.209303, 0.504434],
                [0.270595, 0.214069, 0.507052],
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
