tandav/ultrasonic-stethoscope/mic_speakers_bmp/util.py

import signal
import numpy as np
class DelayedKeyboardInterrupt:
    '''https://stackoverflow.com/questions/842557'''
    def __enter__(self):
        self.signal_received = False
        self.old_handler = signal.signal(signal.SIGINT, self.handler)

    def handler(self, sig, frame):
        self.signal_received = (sig, frame)
        print('SIGINT received. Delaying KeyboardInterrupt.')

    def __exit__(self, type, value, traceback):
        signal.signal(signal.SIGINT, self.old_handler)
        if self.signal_received:
            self.old_handler(*self.signal_received)

def byte_to_float(b): return np.frombuffer(b, dtype=np.float32)[0]
