tandav/ultrasonic-stethoscope/(commit log)

2016-05-22 fast-log
    X-axis layout isn’t workin
2016-09-14 September updates
    I don’t give a fuck about what changes is that
2016-10-13 сменил тему курсовой
2016-10-20 added x-axis shift
2016-10-22 kernelchip sensor1 added
    both sensor1 add sensor2 are on 1 chart now
2016-10-22 both sensors on 1 chart - bugfixes
2016-10-24 both program 1/2
    now only mic
    neeed to add sensors
2016-11-17 added console programs from lcard.ru
    works well on windows powershell
2016-11-28 add adc
2017-02-15 add la12-adc MVP
2017-03-05 add zoom buttons
2017-03-06 set better initials for better performance
    * Timer_interval = 1ms
    * SAMPLE_FREQ =
    * BSIZE = SAMPLE_FREQ / 1000
    You can increase BS and SF by 10, but then reduce number of points to
    draw by 10. (Actualy FPS will be small)
2017-05-03 add Amplifier Circuit (#15)
    add image and sprint layout project
    [Amplifier.lay6]
2017-05-05 более менее сделал введение
2017-05-07 complete ADC description
2017-05-18 Add Arduino ADC App (#18)
    Using PyQt, sockets, sending compressed binaries to cuda-servers to do FFT, then get picture of spectre back to client.
2017-05-22 fix critical threading bug
    There was a bug that causes send_to_cuda() thread write to file one
    piece of signal several times.
    This patch uses common buffer for threads in which data is recorded
    when you click on record button.
    When you click on stop button signal-fetching thread stops writing to
    the buffer and send_to_cuda thread start its job.
    [app.py]
2017-05-25 better device connection UX
2017-05-25 add convert to voltage and filter almost-zero values
2017-05-25 fix bug when app leaves serial port opened on exit
    add port.close() on exit. Now you ain’t need to reboot arduino on each
    app run
    [app.py]
2017-05-25 combine two record/stop buttons into one
2017-05-30 Real Frequencies on chart (#20)
    * add global record_time and rate
    * logscale works well
    * fix spinbox bug
    * better variables
    * better device connection handling
    * frequencies calculates pretty well
    * true axis labels
    * better chart design
    * add capability to calulate fft localy
    * fix bug when arrays has different sizes
    * clean up
    * Major Tweaks
    - add command line args
    - add open png when complete fft
    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
    [app.py]
2017-06-05 better device connection experience
    now you ain need to write exact serial / usb port
2017-06-08 add software/arduino
2017-06-13 upd readme
    * add device photo
    * equal sizes of all photos
    * new headings
2017-09-06 move device searching and connecting routine to SerialReader class
2017-09-07 more specific name for serial reader thread instance
2017-09-08 reorg file structure
    [Amplifier.lay6]
2017-09-16 move arduino firmware to tools
2017-10-14 Add spectrogram plot (#23)
    * some upds to generator
    * tryna make spectrogram
    * add simple image
    * new spectral parameters
    * new generator
    * fft_window > NFFT
    * spectrogram mvp
    * working spectrogram(alpha)
    * better spectrogram
    * better colormap
    * del pyfftw
    * del pyfftw
    * backup
    * make NFFT global
    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
    [app-v2.py, app.py, byte-to-array.py, charts.py, fft-time-test.py, generator.py, intel-benchmarks-2.py, intel-benchmarks.py]
2017-11-09 fix device photo link in README
2017-11-22 docs updates
    [Amplifier.lay6]
2018-05-20 acoustic pressure plots and bugfixes
2018-05-20 now there is 3 slices z-axis, y-axis, x-axis
    also minor improvements
2018-08-14 del adc resolution
2018-09-11 add bmp280 sensor test code
2019-05-04 [checkpoint] 3 in one: adc-mic, 2bmp280, beep
2019-05-12 scipy.fftpack -> np.fft
    looks way better (del freq duplicates)
    freqs still wrong
    [gui.py, main.py, serial_port.py, simple_reader.py]
2019-05-12 Короче не понял по какой причине - но нужно делить rate/2 Если делишь - то вроде все четко - потом разберусь.
2019-05-23 arduino docs update
2019-05-26 fix critical bug with zeros in circular buffer
    [circular_buffer.py]
